QuantumMatter/Rumission/Hardware/rumission.footprints.3dmodels/pololu-1a-step-down-voltage-regulator-d24v10fx.step

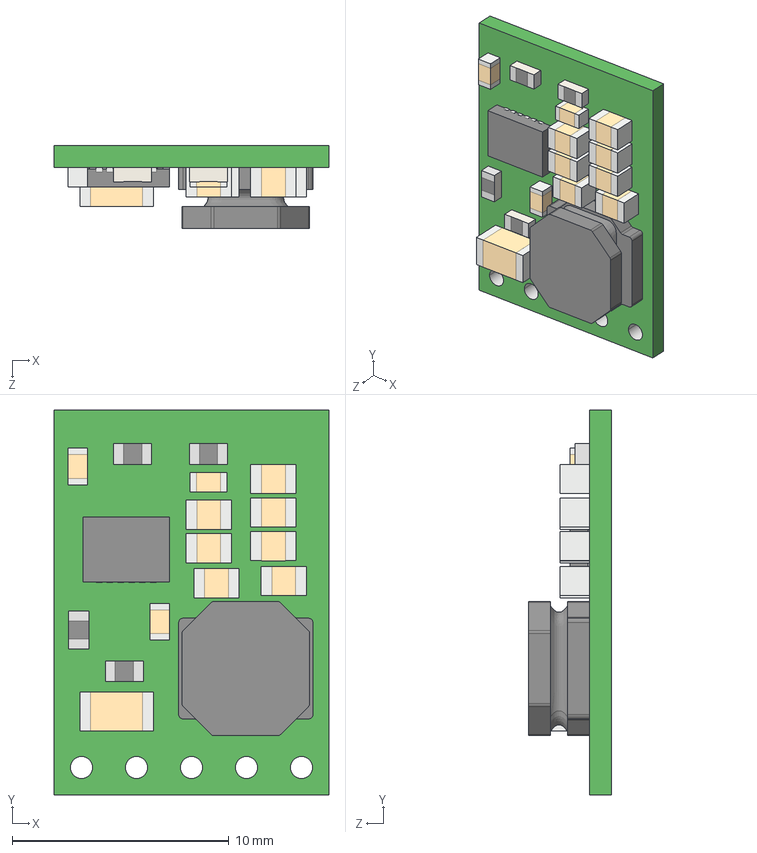
[picture p2: CAD file, 2023-12-21]
Hardware/rumission.footprints.3dmodels/pololu-1a-step-down-voltage-regulator-d24v10fx.step
12.7 x 17.8 x 3.82 mm
