QuantumMatter/Rumission/Hardware/rumission.footprints.3dmodels/SOT-26.stp

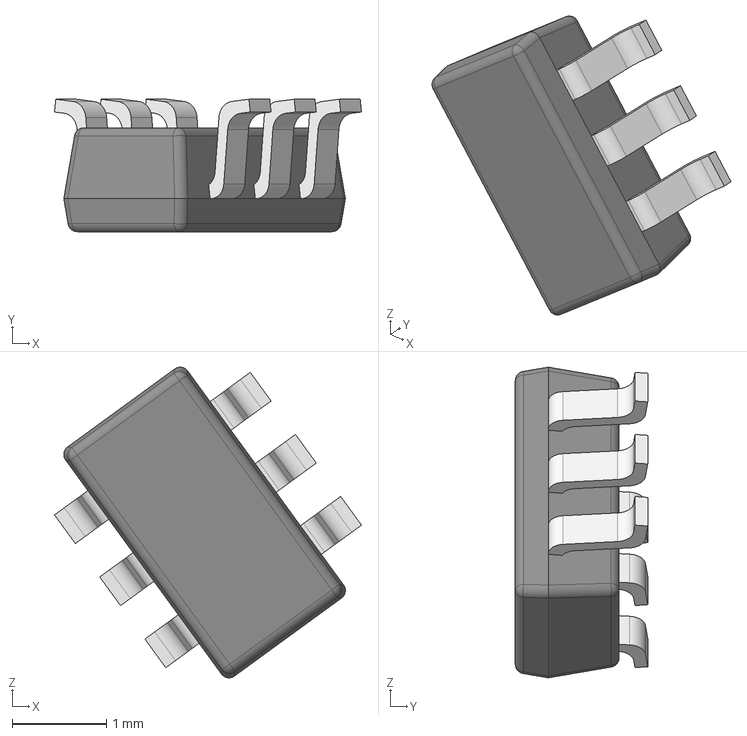
[picture p3: CAD file, 2023-12-21]
Hardware/rumission.footprints.3dmodels/SOT-26.stp
3.25 x 1.40 x 3.29 mm
LF
CP1
