QuantumMatter/Rumission/Hardware/rumission.footprints.3dmodels/Sensirion_Differential_Pressure_Sensors_SDP3x_STEP_file.step

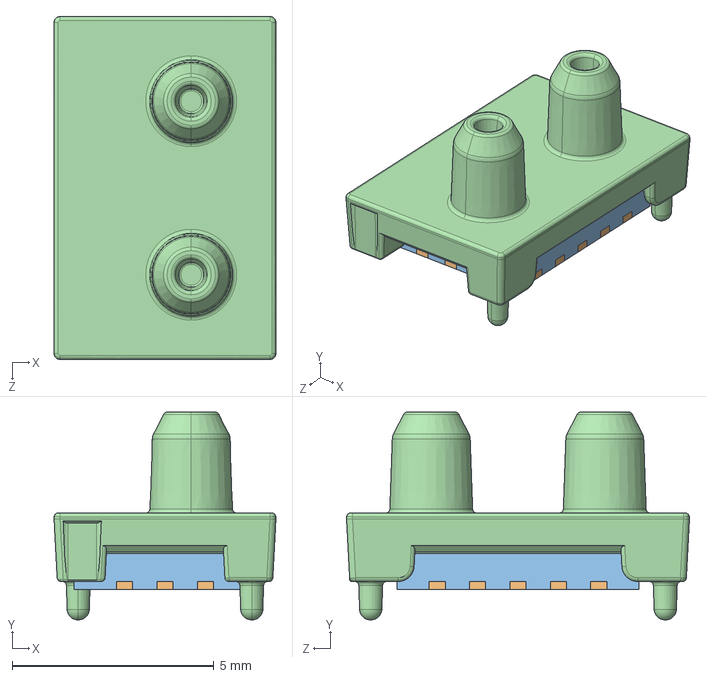
[picture p4: CAD file, 2023-12-21]
Hardware/rumission.footprints.3dmodels/Sensirion_Differential_Pressure_Sensors_SDP3x_STEP_file.step
5.50 x 5.15 x 8.50 mm
