QuantumMatter/Rumission/Hardware/rumission.footprints.3dmodels/CUI_PYBE30-Q24-S12.step

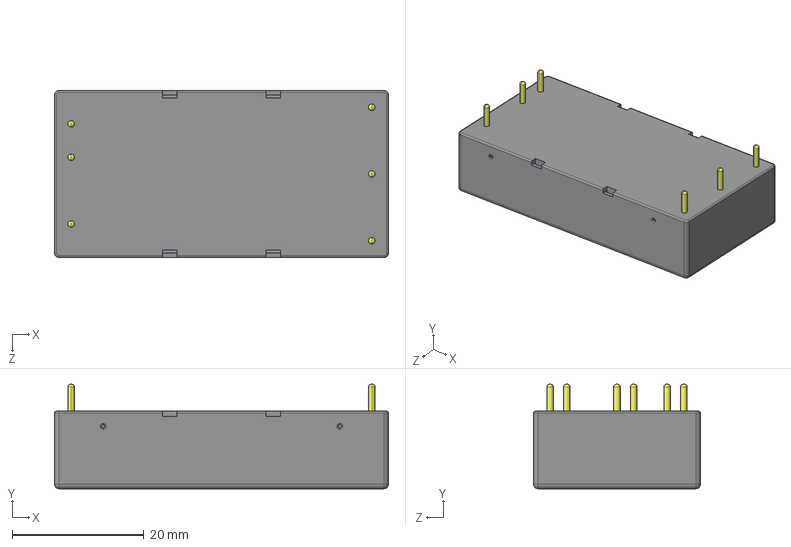
[picture p5: CAD file, 2023-12-21]
Hardware/rumission.footprints.3dmodels/CUI_PYBE30-Q24-S12.step
50.8 x 15.9 x 25.4 mm
