QuantumMatter/Rumission/Hardware/Daughter Boards/dboards-02/10_main_root.kicad_sch

## KiCad design Hardware/Daughter Boards/dboards-02/10_main_root.kicad_sch (2023-12-21)

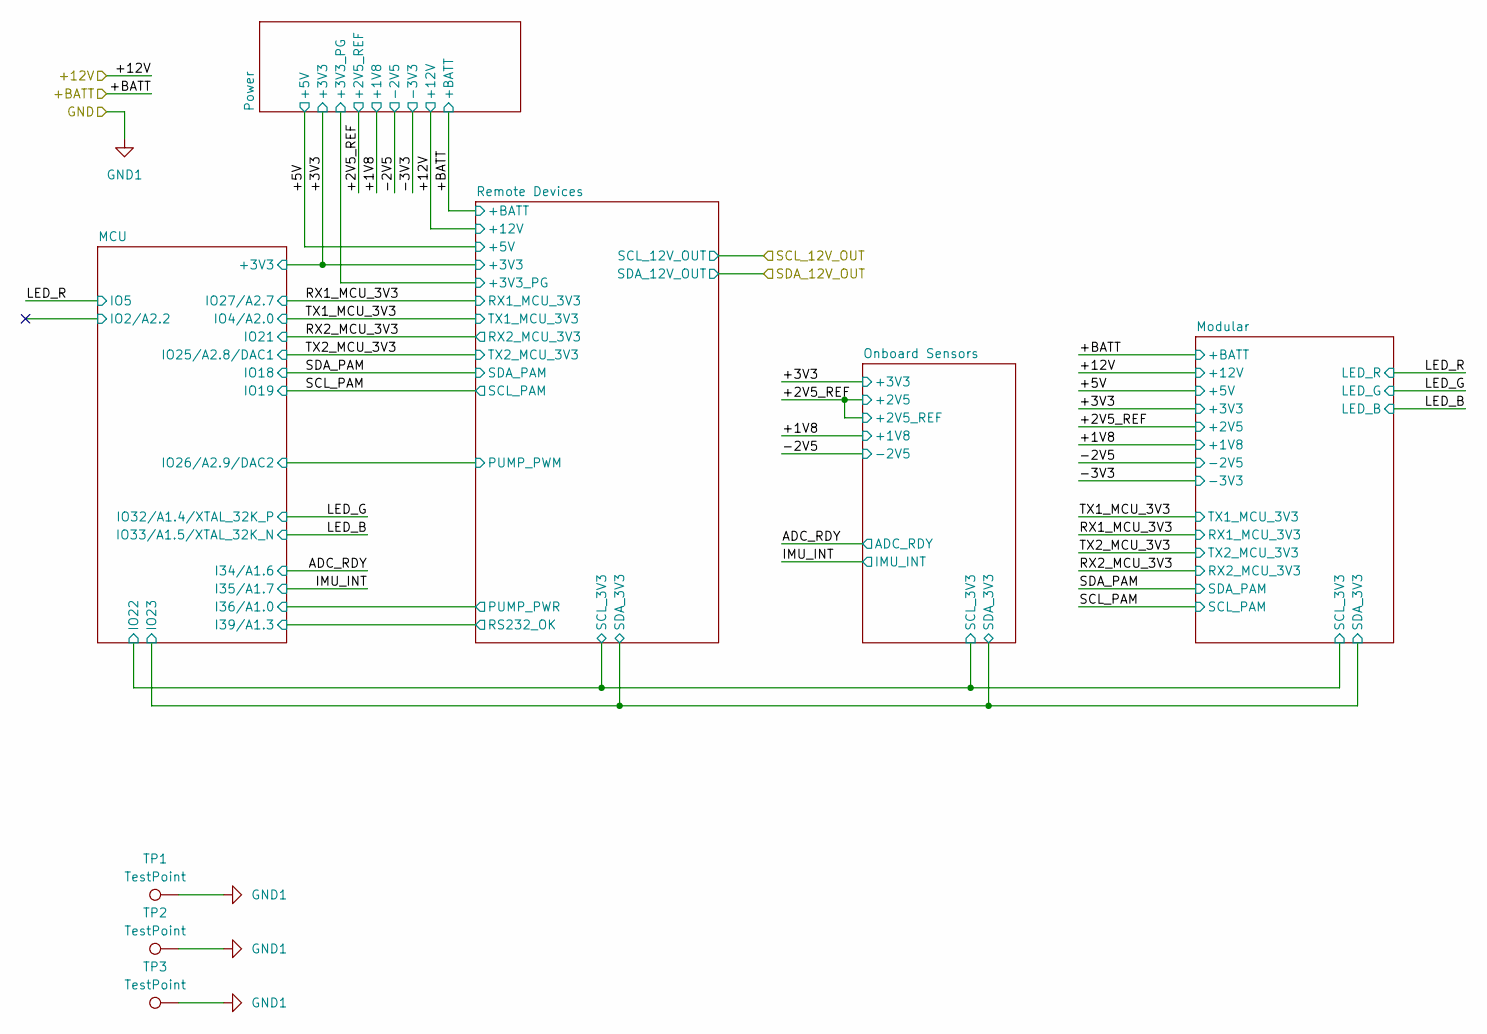
[picture p6: schematic 10_main_root.kicad_sch]

Parts:
TP1, TP2, TP3: TestPoint; TestPoint_Loop_D2.60mm_Drill1.6mm_Beaded; MPN 5011; DigiKey PN 36-5011-ND

Connections:
GND1: TP1.1, TP2.1, TP3.1
