QuantumMatter/Rumission/Hardware/Daughter Boards/dboards-02/11_main_mcu.kicad_sch

## KiCad design Hardware/Daughter Boards/dboards-02/11_main_mcu.kicad_sch (2023-12-21)

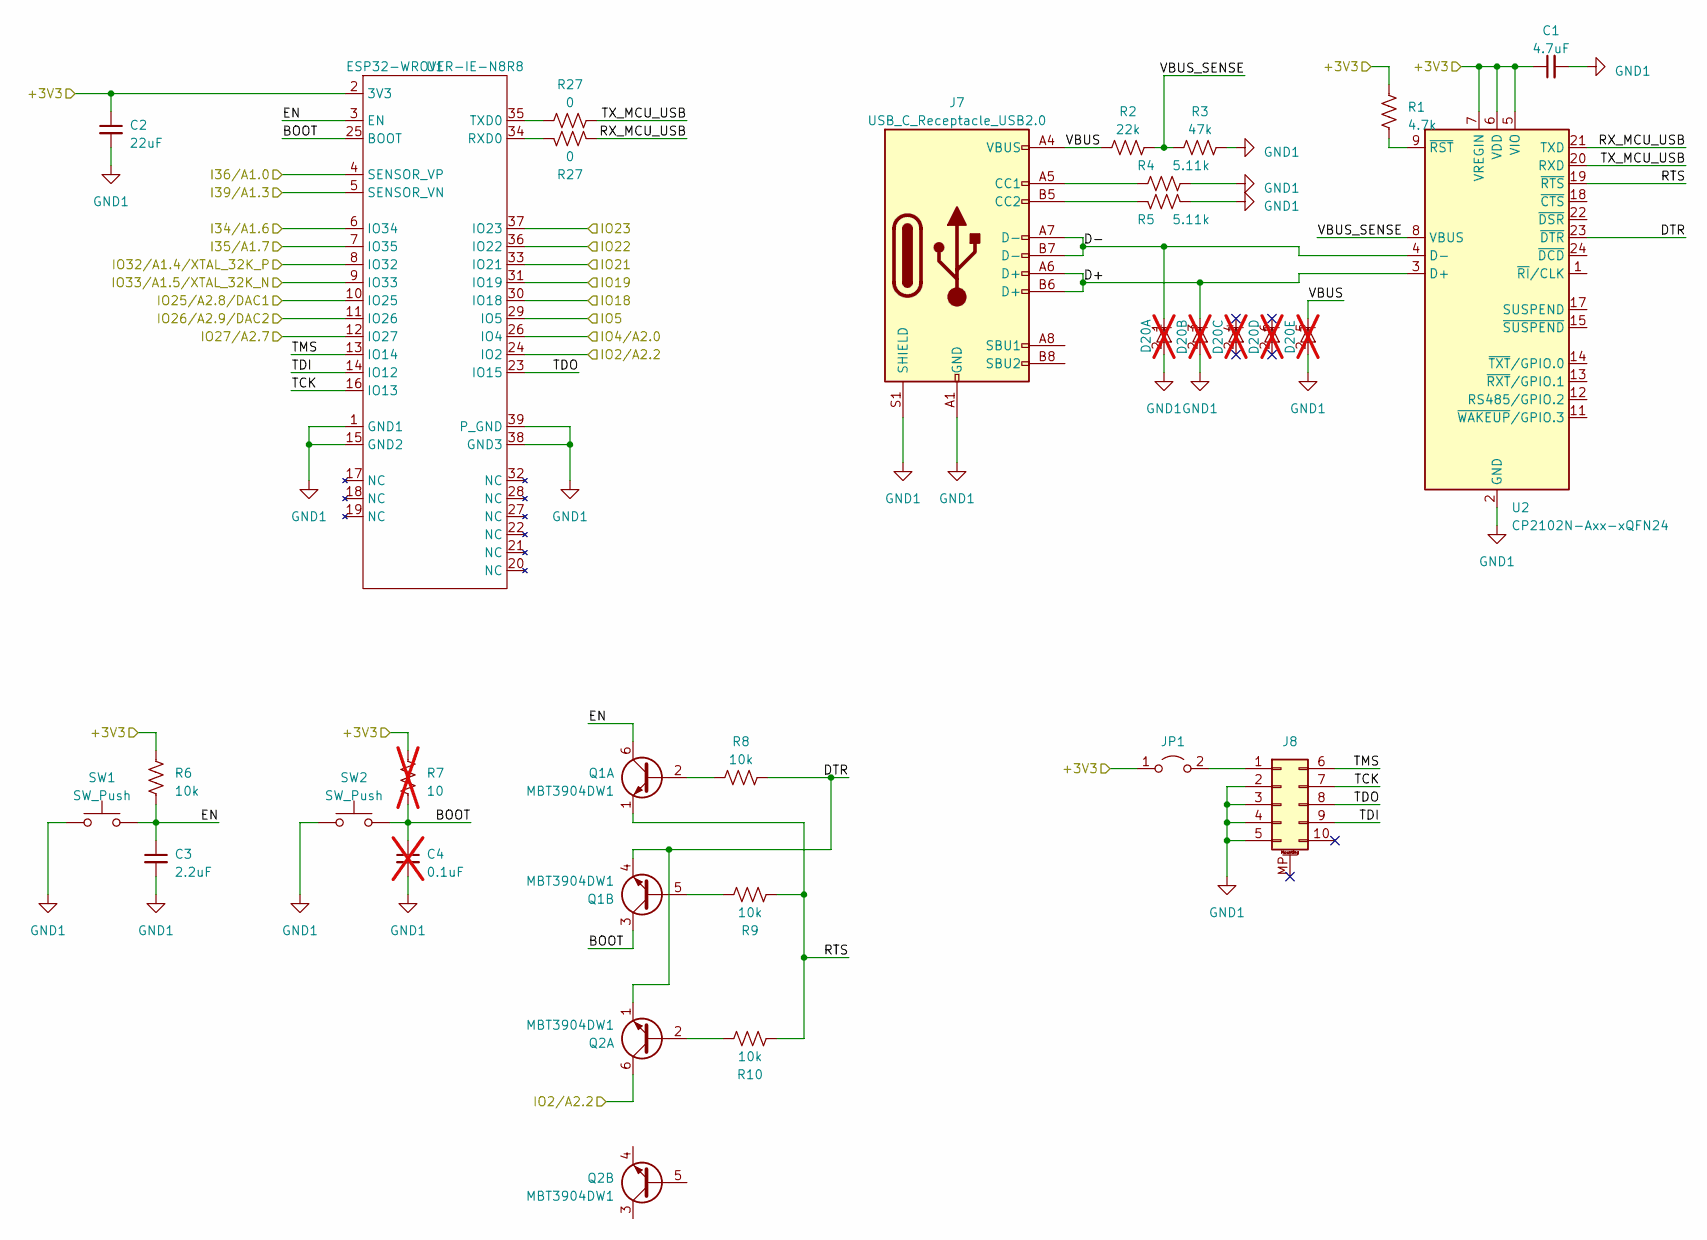
[picture p7: schematic 11_main_mcu.kicad_sch]

Parts:
C1: 4.7uF; C_0805_2012Metric_Pad1.18x1.45mm_HandSolder; MPN CL21A475KAQNNNE; DigiKey PN 1276-1244-1-ND
C2: 22uF; C_0805_2012Metric_Pad1.18x1.45mm_HandSolder; MPN CL21A226MOCLRNC; DigiKey PN 1276-6780-1-ND
C3: 2.2uF; CP_Radial_D5.0mm_P2.00mm; MPN ESK225M100AC3AA; DigiKey PN 399-18273-ND
C4: 0.1uF; C_Disc_D5.0mm_W2.5mm_P5.00mm; MPN FA28X8R1E104KNU00; DigiKey PN 445-181217-ND; not fitted
D20: D5V0F4U6SO; SOT26; MPN D5V0F4U6SO-7; DigiKey PN D5V0F4U6SO-7DICT-ND; not fitted
J7: USB_C_Receptacle_USB2.0; USB_C_Receptacle_GCT_USB4115-03-C; MPN USB4115-03-C; DigiKey PN 2073-USB4115-03-CCT-ND
J8: Conn_02x05_Top_Bottom_MountingPin; PinSocket_2x05_P2.54mm_Vertical; MPN 302-S101; DigiKey PN ED1543-ND
JP1: Jumper_2_Open; PinHeader_1x02_P2.54mm_Vertical; MPN 77311-118-02LF; DigiKey PN 609-4434-ND
Q1, Q2: MBT3904DW1; SOT-363_SC-70-6; MPN MBT3904DW1T3G; DigiKey PN MBT3904DW1T3GOSCT-ND
R1: 4.7k; R_0805_2012Metric_Pad1.20x1.40mm_HandSolder; MPN MFR-25FTF52-4K7; DigiKey PN 13-MFR-25FTF52-4K7CT-ND
R2: 22k; R_Axial_DIN0207_L6.3mm_D2.5mm_P10.16mm_Horizontal; MPN MFR-25FRF52-22K; DigiKey PN 13-MFR-25FRF52-22KCT-ND
R3: 47k; R_Axial_DIN0207_L6.3mm_D2.5mm_P10.16mm_Horizontal; MPN MFR-25FRF52-47K; DigiKey PN 13-MFR-25FRF52-47KCT-ND
R4, R5: 5.11k; R_Axial_DIN0207_L6.3mm_D2.5mm_P10.16mm_Horizontal; MPN MFR-25FRF52-5K11; DigiKey PN 13-MFR-25FRF52-5K11CT-ND
R6: 10k; R_Axial_DIN0207_L6.3mm_D2.5mm_P10.16mm_Horizontal; MPN MFR-25FRF52-10K; DigiKey PN 13-MFR-25FRF52-10KCT-ND
R7: 10; R_Axial_DIN0207_L6.3mm_D2.5mm_P10.16mm_Horizontal; MPN MFR-25FTF52-10R; DigiKey PN 13-MFR-25FTF52-10RCT-ND; not fitted
R8, R9, R10: 10k; R_0805_2012Metric_Pad1.20x1.40mm_HandSolder; MPN RC0805FR-0710KL; DigiKey PN 311-10.0KCRCT-ND
R27: 0; R_0805_2012Metric_Pad1.20x1.40mm_HandSolder; MPN RC0805JR-070RL; DigiKey PN 311-0.0ARCT-ND
SW1: SW_Push; SW_SPST_PTS645; MPN PTS645SH43SMTR92 LFS; DigiKey PN CKN11907CT-ND
SW2: SW_Push; SW_SPST_PTS645; MPN PTS645SM43SMTR92 LFS; DigiKey PN CKN9112CT-ND
U1: ESP32-WROVER-IE-N8R8; ESP32-WROVER; MPN ESP32-WROVER-IE-N8R8; DigiKey PN 1965-ESP32-WROVER-IE-N8R8CT-ND
U2: CP2102N-Axx-xQFN24; QFN-24-1EP_4x4mm_P0.5mm_EP2.6x2.6mm; MPN CP2102N-A02-GQFN24; DigiKey PN 336-5887-ND

Connections:
+3V3: C1.1, C2.1, JP1.1 (A), R1.1, R6.1, R7.1, U1.2 (3V3), U2.5 (VIO), U2.6 (VDD), U2.7 (VREGIN)
BOOT: C4.1, Q1.3 (C2), R7.2, SW2.2, U1.25 (BOOT)
D+: D20.3 (K2), J7.A6 (D+), J7.B6 (D+), U2.3 (D+)
D-: D20.1 (K1), J7.A7 (D-), J7.B7 (D-), U2.4 (D-)
DTR: Q1.4 (E2), Q2.1 (E1), R8.2, U2.23 (~DTR)
EN: C3.1, Q1.6 (C1), R6.2, SW1.2, U1.3 (EN)
GND1: C1.2, C2.2, C3.2, C4.2, D20.2 (A), J7.A1 (GND), J7.A12 (GND), J7.B1 (GND), J7.B12 (GND), J7.S1 (SHIELD), J8.2, J8.3, J8.4, J8.5, R3.1, R4.1, R5.1, SW1.1, SW2.1, U1.1 (GND1), U1.15 (GND2), U1.38 (GND3), U1.39 (P_GND), U2.2 (GND), U2.25 (GND)
I34/A1.6: U1.6 (IO34)
I35/A1.7: U1.7 (IO35)
I36/A1.0: U1.4 (SENSOR_VP)
I39/A1.3: U1.5 (SENSOR_VN)
IO2/A2.2: Q2.6 (C1), U1.24 (IO2)
IO4/A2.0: U1.26 (IO4)
IO5: U1.29 (IO5)
IO18: U1.30 (IO18)
IO19: U1.31 (IO19)
IO21: U1.33 (IO21)
IO22: U1.36 (IO22)
IO23: U1.37 (IO23)
IO25/A2.8/DAC1: U1.10 (IO25)
IO26/A2.9/DAC2: U1.11 (IO26)
IO27/A2.7: U1.12 (IO27)
IO32/A1.4/XTAL_32K_P: U1.8 (IO32)
IO33/A1.5/XTAL_32K_N: U1.9 (IO33)
unnamed: J7.A5 (CC1), R4.2
unnamed: J7.B5 (CC2), R5.2
unnamed: J8.1, JP1.2 (B)
unnamed: Q1.2 (B1), R8.1
unnamed: Q1.5 (B2), R9.1
unnamed: Q2.2 (B1), R10.1
unnamed: R1.2, U2.9 (~RST)
unnamed: R27.1, U1.34 (RXD0), U1.35 (TXD0)
RTS: Q1.1 (E1), R9.2, R10.2, U2.19 (~RTS)
RX_MCU_USB: R27.2, U2.21 (TXD)
TCK: J8.7, U1.16 (IO13)
TDI: J8.9, U1.14 (IO12)
TDO: J8.8, U1.23 (IO15)
TMS: J8.6, U1.13 (IO14)
TX_MCU_USB: R27.2, U2.20 (RXD)
VBUS: D20.5 (K_Vcc), J7.A4 (VBUS), J7.A9 (VBUS), J7.B4 (VBUS), J7.B9 (VBUS), R2.1
VBUS_SENSE: R2.2, R3.2, U2.8 (VBUS)
