QuantumMatter/Rumission/Hardware/Daughter Boards/dboards-02/12_main_power.kicad_sch

## KiCad design Hardware/Daughter Boards/dboards-02/12_main_power.kicad_sch (2023-12-21)

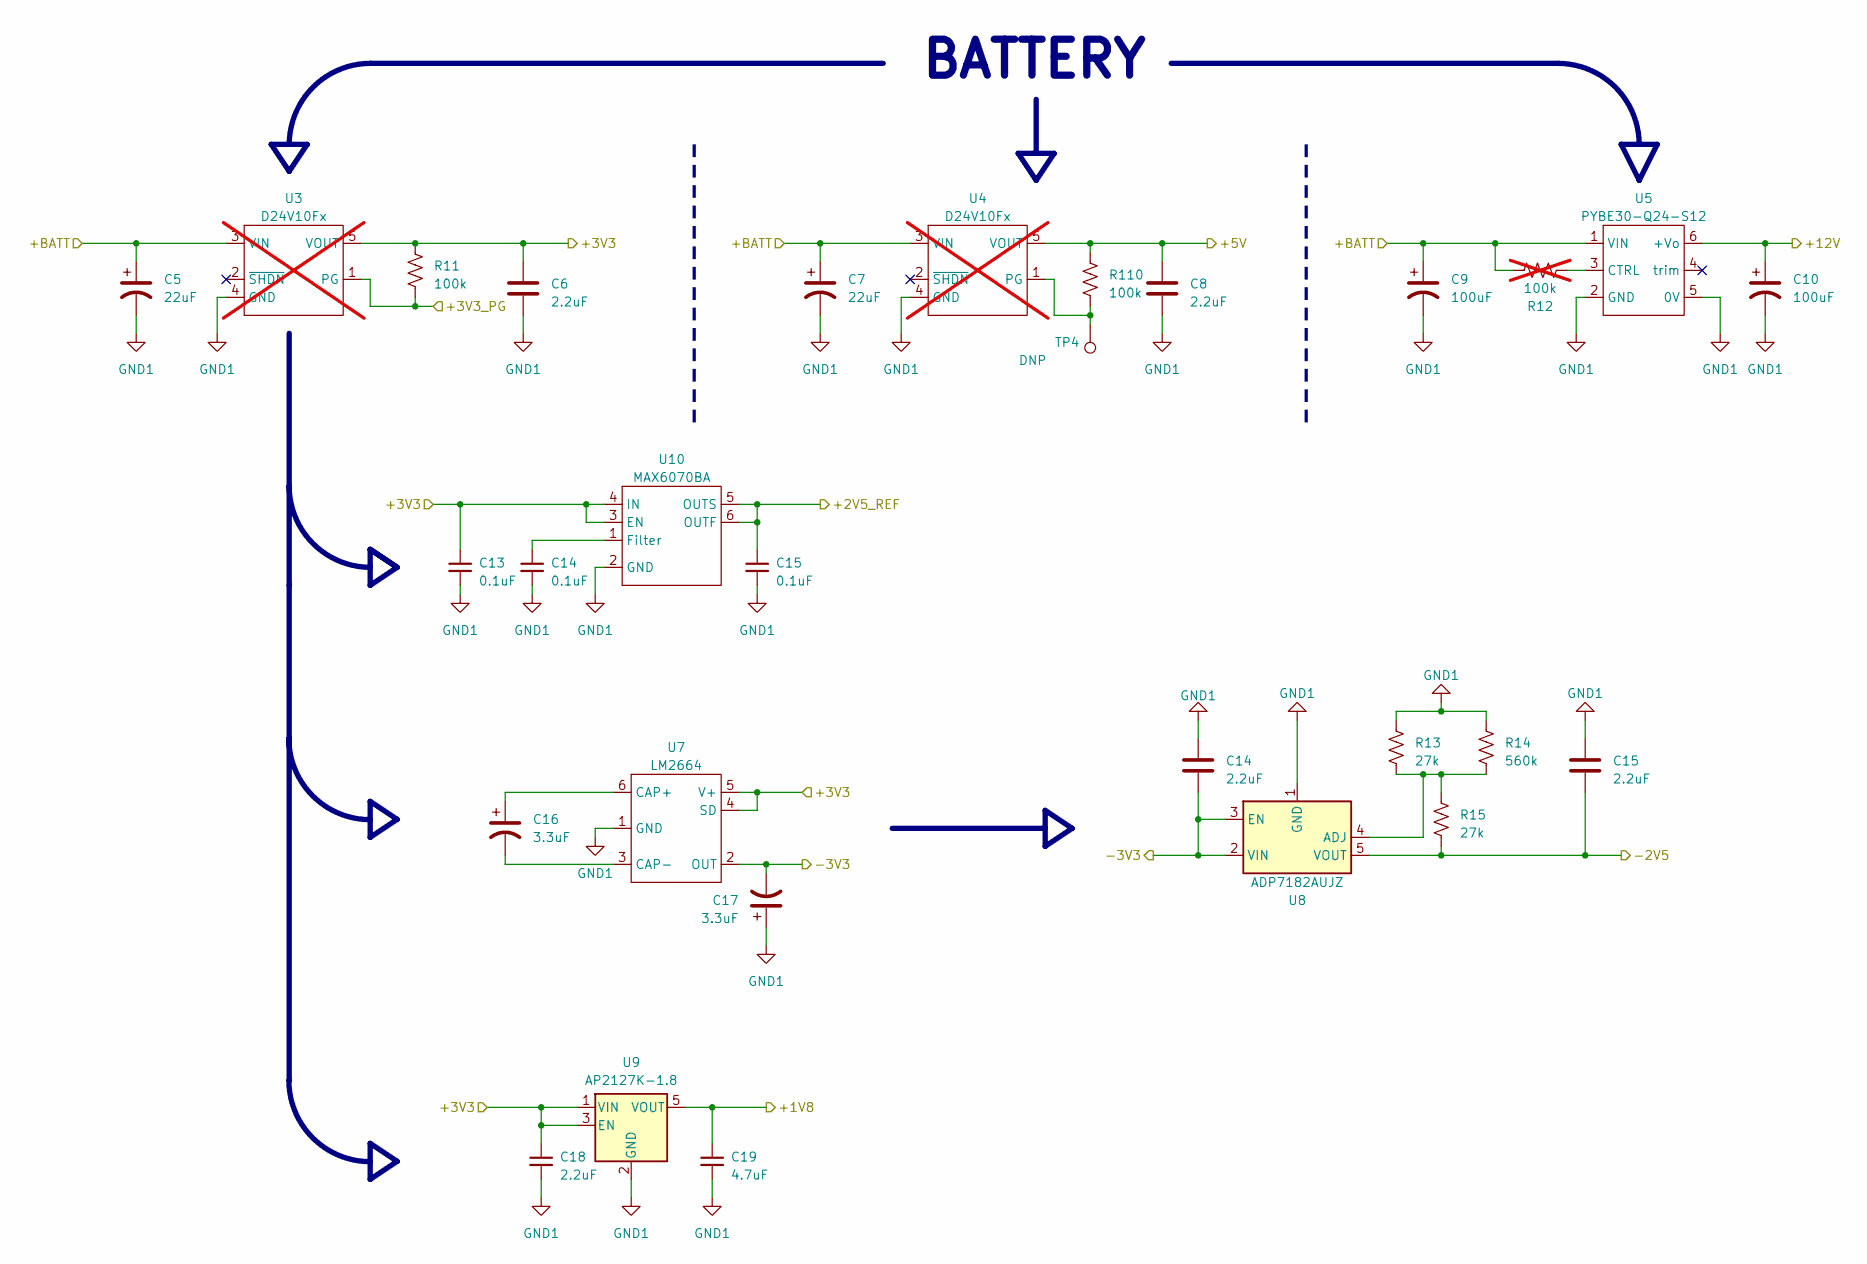
[picture p8: schematic 12_main_power.kicad_sch]

Parts:
C5, C7: 22uF; CP_Radial_D6.3mm_P2.50mm; MPN EEA-GA1H2R2H; DigiKey PN P15835CT-ND
C6, C8, C14, C18: 2.2uF; C_0805_2012Metric_Pad1.18x1.45mm_HandSolder; MPN CL21B225KPFNNNE; DigiKey PN 1276-1188-1-ND
C9, C10: 100uF; CP_Radial_D6.3mm_P2.50mm; MPN ESK107M025AE3EA; DigiKey PN 399-6650-1-ND
C13, C15: 0.1uF; C_0805_2012Metric_Pad1.18x1.45mm_HandSolder; MPN CL21B104KACNNNC; DigiKey PN 1276-1099-1-ND
C16, C17: 3.3uF; C_0805_2012Metric_Pad1.18x1.45mm_HandSolder; MPN CL21A335KPFNNNG; DigiKey PN 1276-6461-1-ND
C19: 4.7uF; C_0805_2012Metric_Pad1.18x1.45mm_HandSolder; MPN CL21A475KAQNNNE; DigiKey PN 1276-1244-1-ND
R11, R110: 100k; R_0805_2012Metric_Pad1.20x1.40mm_HandSolder; MPN RC0805FR-07100KL; DigiKey PN 311-100KCRCT-ND
R12: 100k; R_Axial_DIN0207_L6.3mm_D2.5mm_P10.16mm_Horizontal; MPN MFR-25FRF52-100K; DigiKey PN 13-MFR-25FRF52-100KCT-ND; not fitted
R13, R15: 27k; R_Axial_DIN0207_L6.3mm_D2.5mm_P10.16mm_Horizontal; MPN MFR-25FRF52-27K; DigiKey PN 13-MFR-25FRF52-27KCT-ND
R14: 560k; R_Axial_DIN0207_L6.3mm_D2.5mm_P10.16mm_Horizontal; MPN MFR-25FRF52-560K; DigiKey PN 13-MFR-25FRF52-560KCT-ND
TP4: DNP; TestPoint_Pad_2.0x2.0mm
U3: D24V10Fx; MPN D24V10F3; not fitted
U4: D24V10Fx; MPN D24V10F5; not fitted
U5: PYBE30-Q24-S12; DIP-6-DCDC; MPN PYBE30-Q24-S12; DigiKey PN 102-6018-ND
U7: LM2664; SOT-23-6; MPN LM2664M6/NOPB; DigiKey PN LM2664M6/NOPBCT-ND
U8: ADP7182AUJZ; TSOT-23-5; MPN ADP7182AUJZ-2.5-R7; DigiKey PN 505-ADP7182AUJZ-2.5-R7CT-ND
U9: AP2127K-1.8; SOT-23-5; MPN AP2127K-1.8TRG1; DigiKey PN AP2127K-1.8TRG1DICT-ND
U10: MAX6070BA; SOT-23-6; MPN MAX6070BAUT25+T; DigiKey PN MAX6070BAUT25+TCT-ND

Connections:
+1V8: C19.1, U9.5 (VOUT)
+2V5_REF: C15.1, U10.5 (OUTS), U10.6 (OUTF)
+3V3: C6.1, C13.1, C18.1, R11.1, U3.5 (VOUT), U7.4 (SD), U7.5 (V+), U9.1 (VIN), U9.3 (EN), U10.3 (EN), U10.4 (IN)
+3V3_PG: R11.2, U3.1 (PG)
+5V: C8.1, R110.1, U4.5 (VOUT)
+12V: C10.1, U5.6 (+Vo)
+BATT: C5.1, C7.1, C9.1, R12.2, U3.3 (VIN), U4.3 (VIN), U5.1 (VIN)
-2V5: C15.2, R15.2, U8.5 (VOUT)
-3V3: C14.2, C17.2, U7.2 (OUT), U8.2 (VIN), U8.3 (EN)
GND1: C5.2, C6.2, C7.2, C8.2, C9.2, C10.2, C13.2, C14.1, C14.2, C15.1, C15.2, C17.1, C18.2, C19.2, R13.1, R14.1, U3.4 (GND), U4.4 (GND), U5.2 (GND), U5.5 (0V), U7.1 (GND), U8.1 (GND), U9.2 (GND), U10.2 (GND)
unnamed: C14.1, U10.1 (Filter)
unnamed: C16.1, U7.6 (CAP+)
unnamed: C16.2, U7.3 (CAP-)
unnamed: R12.1, U5.3 (CTRL)
unnamed: R13.2, R14.2, R15.1, U8.4 (ADJ)
unnamed: R110.2, TP4.1, U4.1 (PG)

Notes on the sheet:
BATTERY
