QuantumMatter/Rumission/Hardware/Daughter Boards/dboards-02/13_main_onboard-sensors.kicad_sch

## KiCad design Hardware/Daughter Boards/dboards-02/13_main_onboard-sensors.kicad_sch (2023-12-21)

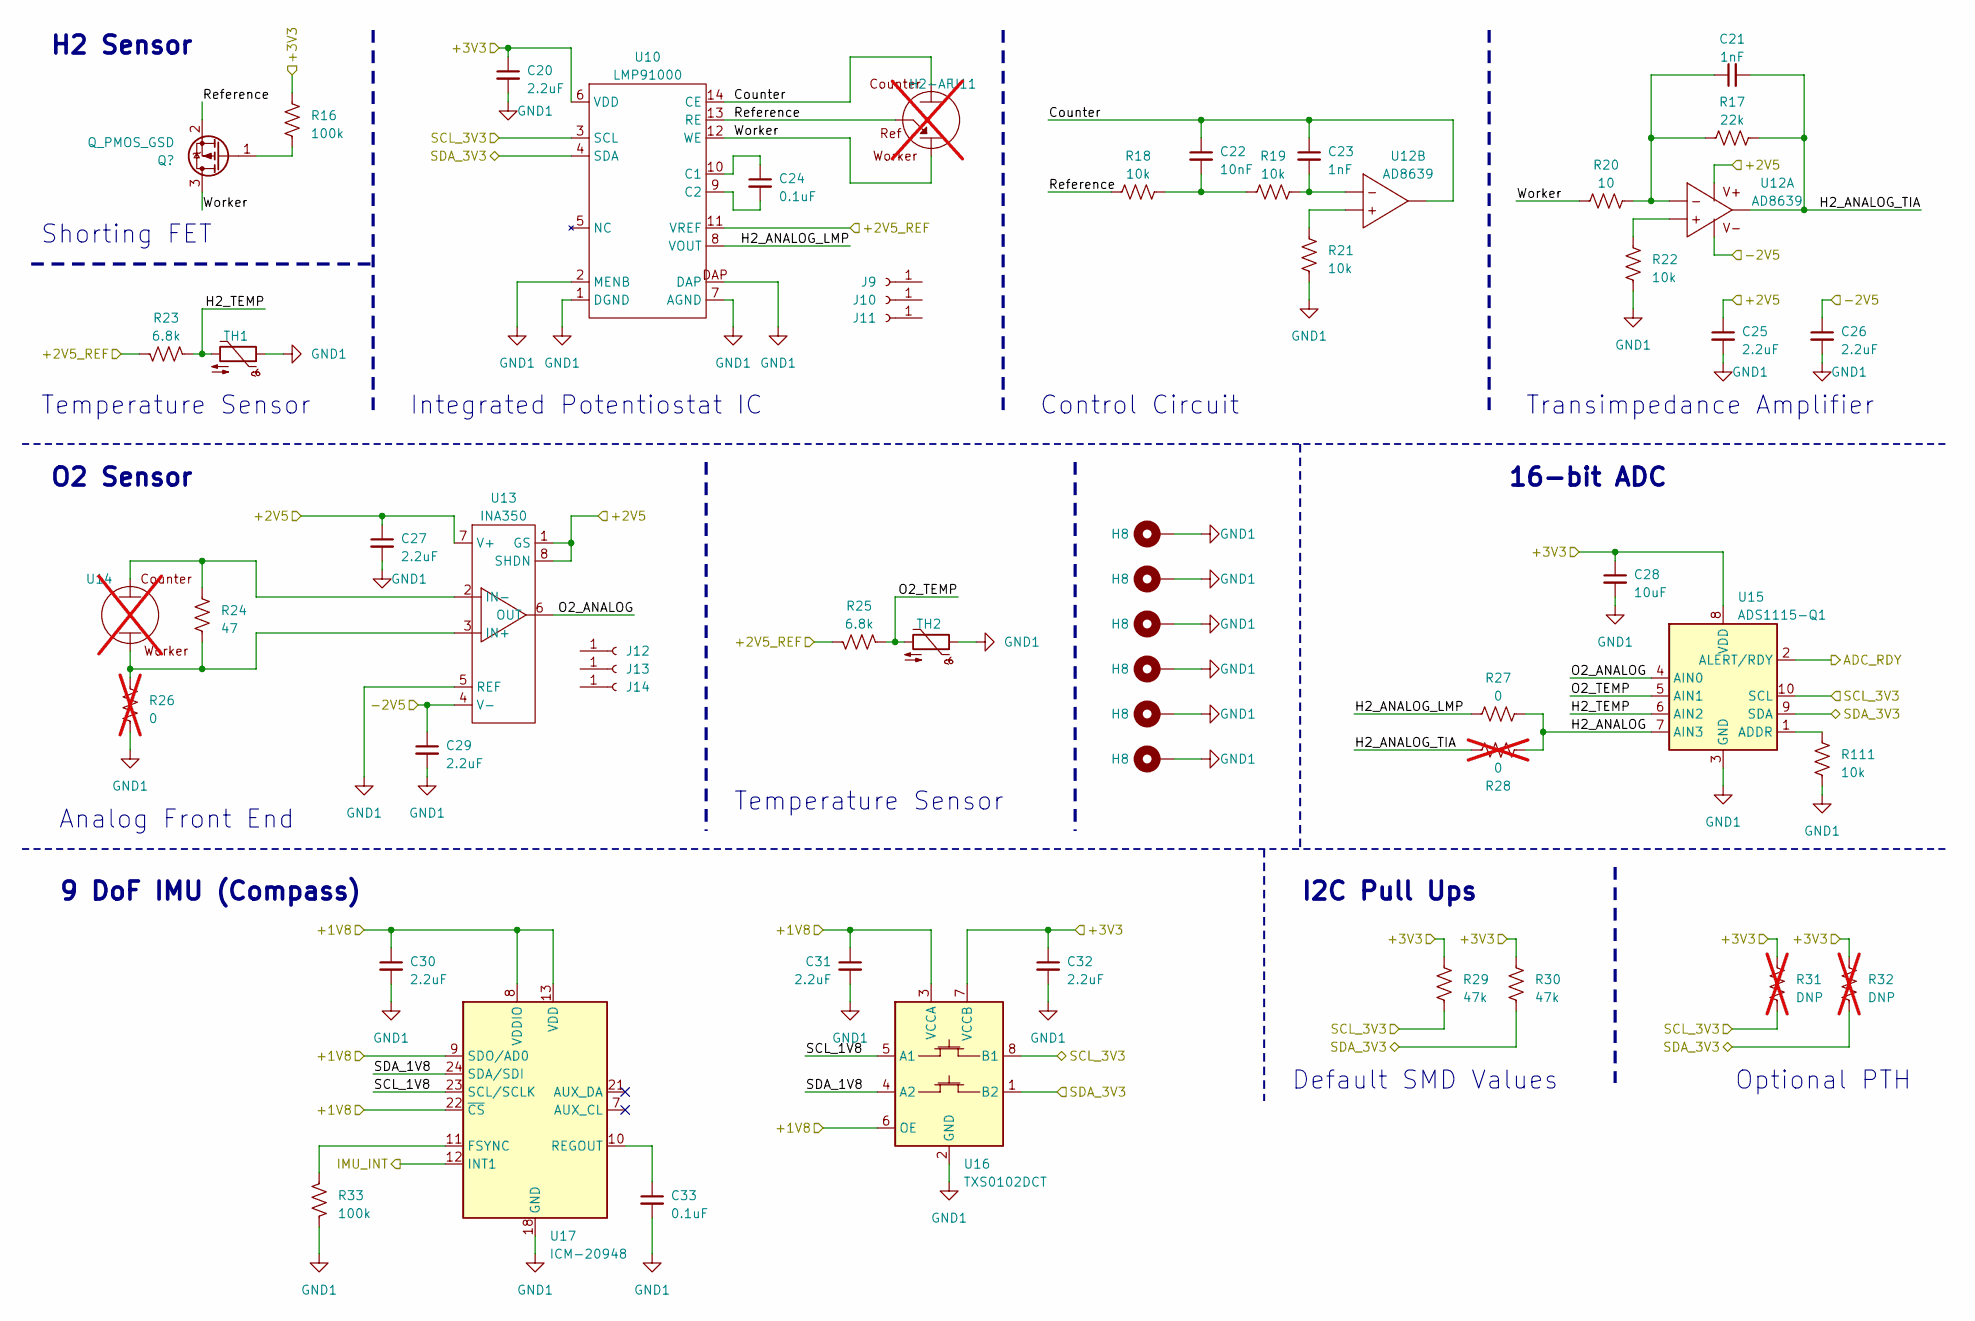
[picture p9: schematic 13_main_onboard-sensors.kicad_sch]

Parts:
C20, C25, C26, C27, C29, C30, C31, C32: 2.2uF; C_0805_2012Metric_Pad1.18x1.45mm_HandSolder; MPN CL21B225KPFNNNE; DigiKey PN 1276-1188-1-ND
C21, C23: 1nF; C_0805_2012Metric_Pad1.18x1.45mm_HandSolder; MPN AC0805KRX7R8BB102; DigiKey PN 311-3167-1-ND
C22: 10nF; C_0805_2012Metric_Pad1.18x1.45mm_HandSolder; MPN AC0805KRX7R8BB103; DigiKey PN 311-3168-1-ND
C24, C33: 0.1uF; C_0805_2012Metric_Pad1.18x1.45mm_HandSolder; MPN CL21B104KACNNNC; DigiKey PN 1276-1099-1-ND
C28: 10uF; C_0805_2012Metric_Pad1.18x1.45mm_HandSolder; MPN CL21A106KOQNNNE; DigiKey PN 1276-1096-1-ND
H8: MountingHole_Pad; MountingHole_3.2mm_M3_DIN965_Pad
J9, J10, J11, J12, J13, J14: 0364 RECEPTACLE WITH NO TAIL; MPN 0364-0-15-15-13-27-10-0; DigiKey PN ED90089-ND
Q1: Q_PMOS_GSD; SOT-523; MPN DMP21D0UT-7; DigiKey PN DMP21D0UT-7DITR-ND
R16: 100k; R_0805_2012Metric_Pad1.20x1.40mm_HandSolder; MPN RC0805FR-07100KL; DigiKey PN 311-100KCRCT-ND
R17: 22k; R_Axial_DIN0207_L6.3mm_D2.5mm_P10.16mm_Horizontal; MPN MFR-25FRF52-22K; DigiKey PN 13-MFR-25FRF52-22KCT-ND
R18, R19, R21, R22, R111: 10k; R_0805_2012Metric_Pad1.20x1.40mm_HandSolder; MPN RC0805FR-0710KL; DigiKey PN 311-10.0KCRCT-ND
R20: 10; R_Axial_DIN0207_L6.3mm_D2.5mm_P10.16mm_Horizontal; MPN MFR-25FTF52-10R; DigiKey PN 13-MFR-25FTF52-10RCT-ND
R23, R25: 6.8k; R_Axial_DIN0207_L6.3mm_D2.5mm_P10.16mm_Horizontal; MPN MFR-25FRF52-6K8; DigiKey PN 13-MFR-25FRF52-6K8CT-ND
R24: 47; R_Axial_DIN0207_L6.3mm_D2.5mm_P10.16mm_Horizontal; MPN MFR-25FTE52-47R; DigiKey PN 13-MFR-25FTE52-47RCT-ND
R26: 0; R_Axial_DIN0207_L6.3mm_D2.5mm_P10.16mm_Horizontal; MPN MFR-25-T-52-0R; DigiKey PN 13-MFR-25-T-52-0RCT-ND; not fitted
R27: 0; R_0805_2012Metric_Pad1.20x1.40mm_HandSolder; MPN RC0805JR-070RL; DigiKey PN 311-0.0ARCT-ND
R28: 0; R_0805_2012Metric_Pad1.20x1.40mm_HandSolder; MPN RC0805JR-070RL; DigiKey PN 311-0.0ARCT-ND; not fitted
R29, R30: 47k; R_0805_2012Metric_Pad1.20x1.40mm_HandSolder; MPN RC0805FR-0747KL; DigiKey PN 311-47.0KCRCT-ND
R31, R32: DNP; R_Axial_DIN0207_L6.3mm_D2.5mm_P10.16mm_Horizontal; not fitted
R33: 100k; R_Axial_DIN0207_L6.3mm_D2.5mm_P10.16mm_Horizontal; MPN MFR-25FRF52-100K; DigiKey PN 13-MFR-25FRF52-100KCT-ND
TH1, TH2: TX08F103F3435ER; R_0805_2012Metric_Pad1.20x1.40mm_HandSolder; MPN TX08F103F3435ER; DigiKey PN 273-TX08F103F3435ERCT-ND
U10: LMP91000; WSON-14-1EP_4.0x4.0mm_P0.5mm_EP2.6x2.6mm; MPN LMP91000SD/NOPB; DigiKey PN 296-44382-1-ND
U11: H2-AF; not fitted
U12: AD8639; SOIC-8_3.9x4.9mm_P1.27mm; MPN AD8639ARZ; DigiKey PN 505-AD8639ARZ-ND
U13: INA350; SOT-23-8; MPN INA350CDSIDDFR; DigiKey PN 296-INA350CDSIDDFRCT-ND
U14: O2-A1; H2-AF; not fitted
U15: ADS1115-Q1; VSSOP-10_3x3mm_P0.5mm; MPN ADS1115BQDGSRQ1; DigiKey PN 296-45221-1-ND
U16: TXS0102DCT; SSOP-8_2.95x2.8mm_P0.65mm; MPN TXS0102DCTR; DigiKey PN 296-21978-1-ND
U17: ICM-20948; InvenSense_QFN-24_3x3mm_P0.4mm; MPN ICM-20948; DigiKey PN 1428-1123-1-ND

Connections:
+1V8: C30.1, C31.1, U16.3 (VCCA), U16.6 (OE), U17.8 (VDDIO), U17.9 (SDO/AD0), U17.13 (VDD), U17.22 (~CS)
+2V5: C25.1, C27.1, U12.4 (V-), U13.1 (GS), U13.7 (V+), U13.8 (SHDN)
+2V5_REF: R23.1, R25.1, U10.11 (VREF)
+3V3: C20.1, C28.1, C32.1, R16.1, R29.1, R30.1, R31.1, R32.1, U10.6 (VDD), U15.8 (VDD), U16.7 (VCCB)
-2V5: C26.1, C29.1, U12.8 (V+), U13.4 (V-)
ADC_RDY: U15.2 (ALERT/RDY)
Counter: C22.1, C23.1, U10.14 (CE), U11.3 (Counter), U12.7 (OUT)
GND1: C20.2, C25.2, C26.2, C27.2, C28.2, C29.2, C30.2, C31.2, C32.2, C33.2, H8.1, R21.1, R22.1, R26.2, R33.2, R111.1, TH1.1, TH2.1, U10.1 (DGND), U10.2 (MENB), U10.7 (AGND), U10.DAP, U13.5 (REF), U15.3 (GND), U16.2 (GND), U17.18 (GND), U17.20 (GND)
H2_ANALOG: R27.2, R28.2, U15.7 (AIN3)
H2_ANALOG_LMP: R27.1, U10.8 (VOUT)
H2_ANALOG_TIA: C21.2, R17.2, R28.1, U12.1 (OUT)
H2_TEMP: R23.2, TH1.2, U15.6 (AIN2)
IMU_INT: U17.12 (INT1)
unnamed: C21.1, R17.1, R20.2, U12.2 (IN-)
unnamed: C22.2, R18.2, R19.1
unnamed: C23.2, R19.2, U12.6 (IN-)
unnamed: C24.1, U10.10 (C1)
unnamed: C24.2, U10.9 (C2)
unnamed: C33.1, U17.10 (REGOUT)
unnamed: Q1.1 (G), R16.2
unnamed: R21.2, U12.5 (IN+)
unnamed: R22.2, U12.3 (IN+)
unnamed: R24.1, U13.2 (IN-), U14.3 (Counter)
unnamed: R24.2, R26.1, U13.3 (IN+), U14.2 (Worker)
unnamed: R33.1, U17.11 (FSYNC)
unnamed: R111.2, U15.1 (ADDR)
O2_ANALOG: U13.6 (OUT), U15.4 (AIN0)
O2_TEMP: R25.2, TH2.2, U15.5 (AIN1)
Reference: Q1.2 (S), R18.1, U10.13 (RE), U11.1 (Reference)
SCL_1V8: U16.5 (A1), U17.23 (SCL/SCLK)
SCL_3V3: R29.2, R31.2, U10.3 (SCL), U15.10 (SCL), U16.8 (B1)
SDA_1V8: U16.4 (A2), U17.24 (SDA/SDI)
SDA_3V3: R30.2, R32.2, U10.4 (SDA), U15.9 (SDA), U16.1 (B2)
Worker: Q1.3 (D), R20.1, U10.12 (WE), U11.2 (Worker)

Notes on the sheet:
H2 Sensor
Integrated Potentiostat IC
Shorting FET
9 DoF IMU (Compass)
Transimpedance Amplifier
Temperature Sensor
O2 Sensor
Optional PTH
Control Circuit
I2C Pull Ups
Default SMD Values
Analog Front End
16-bit ADC
