QuantumMatter/Rumission/Hardware/Daughter Boards/dboards-02/14_main_remote-devices.kicad_sch

## KiCad design Hardware/Daughter Boards/dboards-02/14_main_remote-devices.kicad_sch (2023-12-21)

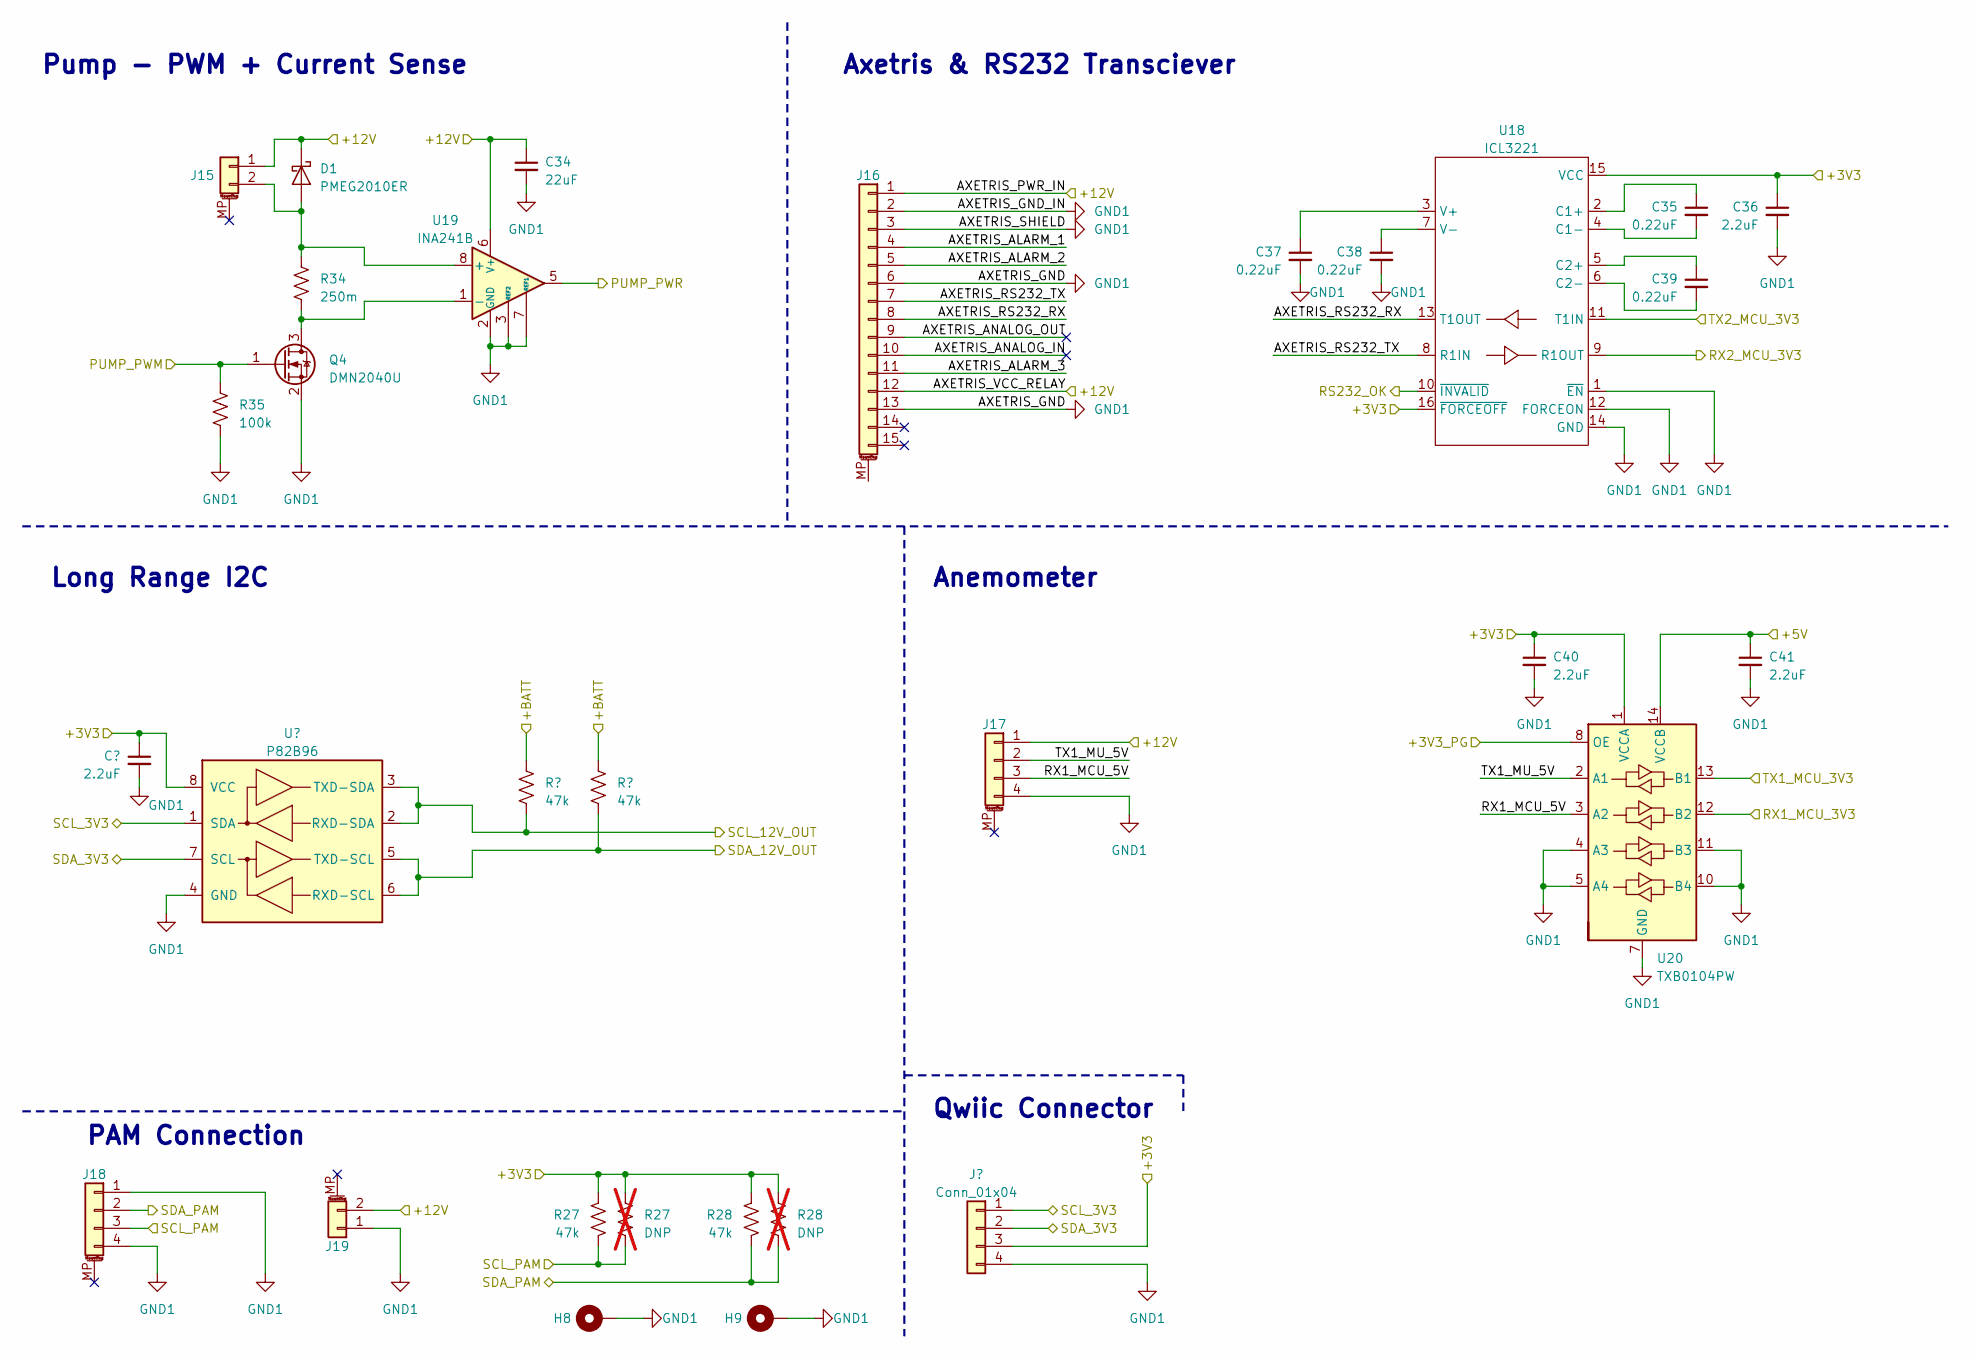
[picture p10: schematic 14_main_remote-devices.kicad_sch]

Parts:
C25, C36, C40, C41: 2.2uF; C_0805_2012Metric_Pad1.18x1.45mm_HandSolder; MPN CL21B225KPFNNNE; DigiKey PN 1276-1188-1-ND
C34: 22uF; CP_Radial_D6.3mm_P2.50mm; MPN EEA-GA1H2R2H; DigiKey PN P15835CT-ND
C35, C37, C38, C39: 0.22uF; C_0805_2012Metric_Pad1.18x1.45mm_HandSolder; MPN CL21B224KAFNNNE; DigiKey PN 1276-1161-1-ND
D1: PMEG2010ER; Nexperia_CFP3_SOD-123W; MPN PMEG2010ER,115; DigiKey PN 1727-5192-1-ND
H8, H9: MountingHole_Pad; MountingHole_3.2mm_M3_DIN965_Pad
J15, J19: Conn_01x02_MountingPin; JST_XH_B2B-XH-AM_1x02_P2.50mm_Vertical; MPN B2B-XH-AM(LF)(SN); DigiKey PN 455-2273-ND
J16: Conn_01x15_MountingPin; DSUB-15_Female_Vertical_P2.77x2.84mm_MountingHoles; MPN D15S24A4GV00LF; DigiKey PN 609-1497-ND
J17, J18: Conn_01x04_MountingPin; JST_XH_B4B-XH-AM_1x04_P2.50mm_Vertical; MPN B4B-XH-AM(LF)(SN); DigiKey PN 455-2237-ND
J22: Conn_01x04; JST_SH_BM04B-SRSS-TB_1x04-1MP_P1.00mm_Vertical; MPN BM04B-SRSS-TB(LF)(SN); DigiKey PN 455-1790-1-ND
Q4: DMN2040U; SOT-523; MPN DMN2040U-13; DigiKey PN 31-DMN2040U-13CT-ND
R27: 47k; R_0805_2012Metric_Pad1.20x1.40mm_HandSolder; MPN RC0805FR-0747KL; DigiKey PN 311-47.0KCRCT-ND
R28, R29: 47k; R_Axial_DIN0207_L6.3mm_D2.5mm_P10.16mm_Horizontal; MPN MFR-25FRF52-47K; DigiKey PN 13-MFR-25FRF52-47KCT-ND
R34: 250m; R_2512_6332Metric_Pad1.40x3.35mm_HandSolder; MPN RL2512FK-070R25L; DigiKey PN 13-RL2512FK-070R25LCT-ND
R35: 100k; R_0805_2012Metric_Pad1.20x1.40mm_HandSolder; MPN RC0805FR-07100KL; DigiKey PN 311-100KCRCT-ND
U15: P82B96; SOIC-8_3.9x4.9mm_P1.27mm; MPN P82B96DR; DigiKey PN 296-20942-1-ND
U18: ICL3221; TSSOP-16_4.4x5mm_P0.65mm; MPN ICL3221ECVZ-T; DigiKey PN ICL3221ECVZ-TCT-ND
U19: INA241B; SOIC-8_3.9x4.9mm_P1.27mm; MPN INA241B1IDDFR; DigiKey PN 296-INA241B1IDDFRCT-ND
U20: TXB0104PW; TSSOP-14_4.4x5mm_P0.65mm; MPN TXB0104PWR; DigiKey PN 296-21929-1-ND

Connections:
+3V3: C25.1, C36.1, C40.1, J22.3, R27.1, R28.1, U15.8 (VCC), U18.15 (VCC), U18.16 (~FORCEOFF), U20.1 (VCCA)
+3V3_PG: U20.8 (OE)
+5V: C41.1, U20.14 (VCCB)
+12V: C34.1, D1.1 (K), J15.1, J16.1, J16.12, J17.1, J19.2, U19.6 (V+)
+BATT: R28.1, R29.1
AXETRIS_ALARM_1: J16.4
AXETRIS_ALARM_2: J16.5
AXETRIS_ALARM_3: J16.11
AXETRIS_ANALOG_IN: J16.10
AXETRIS_ANALOG_OUT: J16.9
AXETRIS_RS232_RX: J16.8, U18.13 (T1OUT)
AXETRIS_RS232_TX: J16.7, U18.8 (R1IN)
GND1: C25.2, C34.2, C36.2, C37.2, C38.2, C40.2, C41.2, H8.1, H9.1, J16.2, J16.3, J16.6, J16.13, J17.4, J18.1, J18.4, J19.1, J22.4, Q4.2 (S), R35.2, U15.4 (GND), U18.1 (~EN), U18.12 (FORCEON), U18.14 (GND), U19.2 (GND), U19.3 (REF2), U19.4 (GND), U19.7 (REF1), U20.4 (A3), U20.5 (A4), U20.7 (GND), U20.10 (B4), U20.11 (B3)
unnamed: C35.1, U18.2 (C1+)
unnamed: C35.2, U18.4 (C1-)
unnamed: C37.1, U18.3 (V+)
unnamed: C38.1, U18.7 (V-)
unnamed: C39.1, U18.5 (C2+)
unnamed: C39.2, U18.6 (C2-)
unnamed: D1.2 (A), J15.2, R34.1, U19.8 (+)
unnamed: Q4.3 (D), R34.2, U19.1 (-)
PUMP_PWM: Q4.1 (G), R35.1
PUMP_PWR: U19.5
RS232_OK: U18.10 (~INVALID)
RX1_MCU_3V3: U20.12 (B2)
RX1_MCU_5V: J17.3, U20.3 (A2)
RX2_MCU_3V3: U18.9 (R1OUT)
SCL_3V3: J22.1, U15.1 (SDA)
SCL_12V_OUT: R28.2, U15.2 (RXD-SDA), U15.3 (TXD-SDA)
SCL_PAM: J18.3, R27.2
SDA_3V3: J22.2, U15.7 (SCL)
SDA_12V_OUT: R29.2, U15.5 (TXD-SCL), U15.6 (RXD-SCL)
SDA_PAM: J18.2, R28.2
TX1_MCU_3V3: U20.13 (B1)
TX1_MU_5V: J17.2, U20.2 (A1)
TX2_MCU_3V3: U18.11 (T1IN)

Notes on the sheet:
Anemometer
PAM Connection
Qwiic Connector
Long Range I2C
Axetris & RS232 Transciever
Pump - PWM + Current Sense
