QuantumMatter/Rumission/Hardware/Daughter Boards/dboards-02/15_main_modular.kicad_sch

## KiCad design Hardware/Daughter Boards/dboards-02/15_main_modular.kicad_sch (2023-12-21)

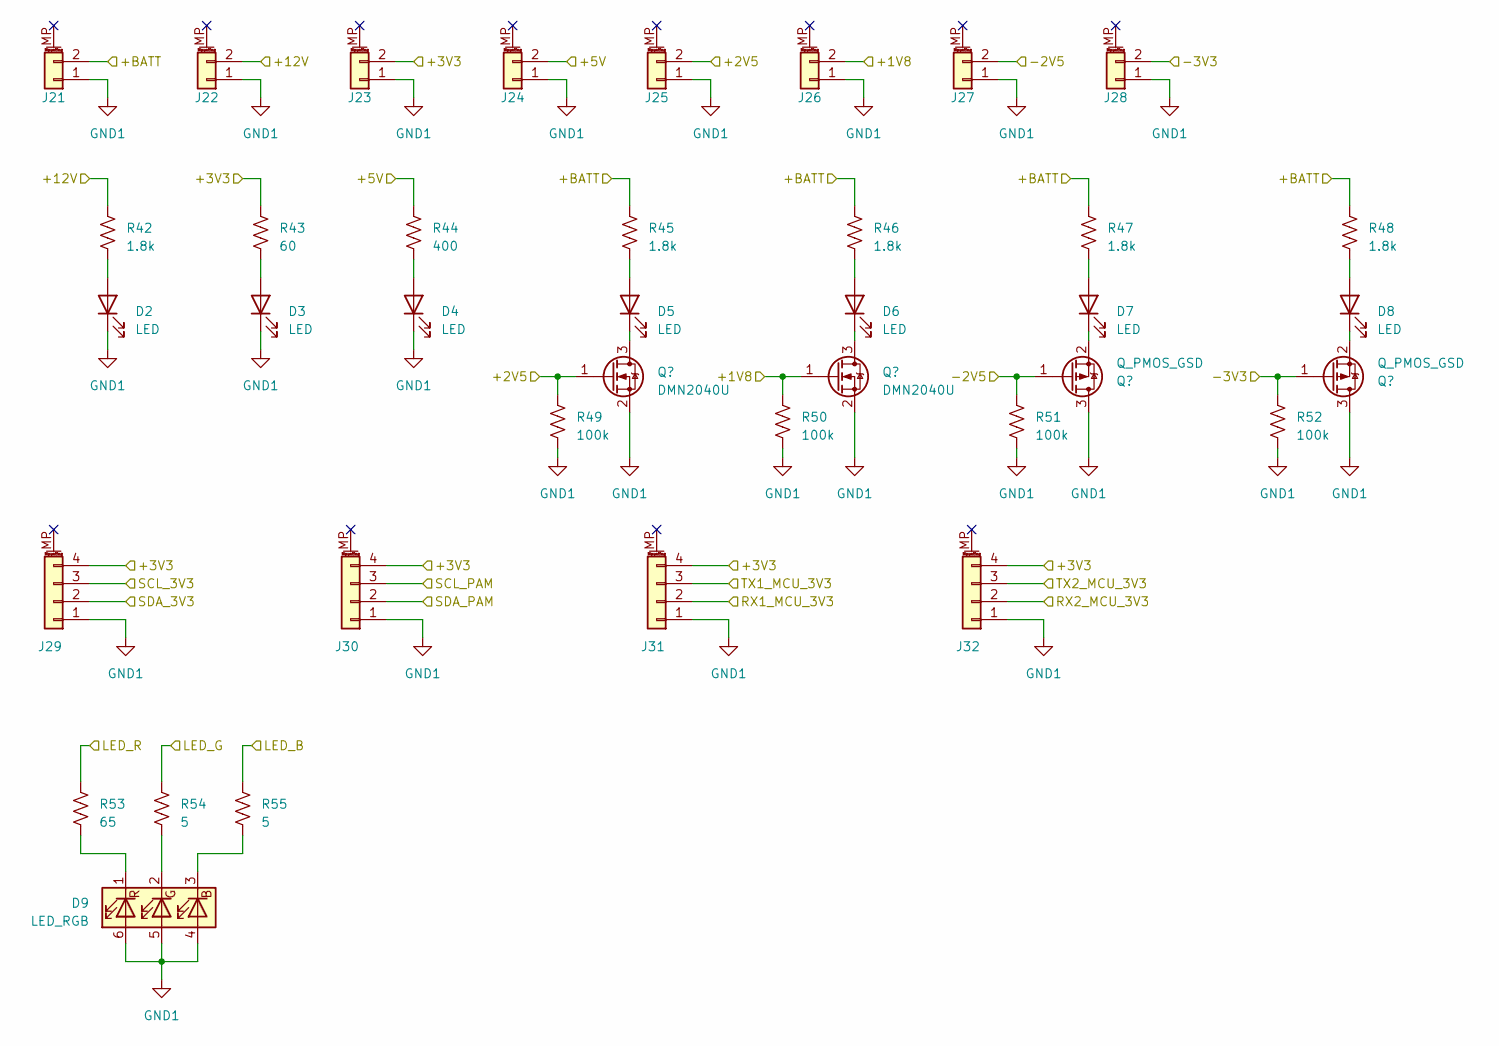
[picture p11: schematic 15_main_modular.kicad_sch]

Parts:
D2, D3, D4, D5, D6, D7, D8: LED; LED_0603_1608Metric_Pad1.05x0.95mm_HandSolder; MPN LTST-C193TGKT-5A; DigiKey PN 160-1832-2-ND
D9: LED_RGB; LED_RGB_Cree-PLCC-6_6x5mm_P2.1mm; MPN CLP6C-FKB-CKNPRGJBB7A363; DigiKey PN CLP6C-FKB-CKNPRGJBB7A363TR-ND
J21, J22, J23, J24, J25, J26, J27, J28: Conn_01x02_MountingPin; JST_XH_B2B-XH-AM_1x02_P2.50mm_Vertical; MPN B2B-XH-AM(LF)(SN); DigiKey PN 455-2273-ND
J29, J30, J31, J32: Conn_01x04_MountingPin; JST_XH_B4B-XH-AM_1x04_P2.50mm_Vertical; MPN B4B-XH-AM(LF)(SN); DigiKey PN 455-2237-ND
Q5: Q_PMOS_GSD; SOT-523; MPN DMP21D0UT-7; DigiKey PN DMP21D0UT-7DITR-ND
Q6: DMN2040U; SOT-523; MPN DMN2040U-13; DigiKey PN 31-DMN2040U-13CT-ND
R42, R45, R46, R47, R48: 1.8k; R_Axial_DIN0207_L6.3mm_D2.5mm_P10.16mm_Horizontal; MPN MFR-25FTE52-1K8; DigiKey PN 13-MFR-25FTE52-1K8CT-ND
R43: 60; R_Axial_DIN0207_L6.3mm_D2.5mm_P10.16mm_Horizontal; MPN MFR-25FTE52-59R; DigiKey PN 13-MFR-25FTE52-59RCT-ND
R44: 400; R_Axial_DIN0207_L6.3mm_D2.5mm_P10.16mm_Horizontal; MPN MFR-25FRF52-402R; DigiKey PN 13-MFR-25FRF52-402RCT-ND
R49, R50, R51, R52: 100k; R_0805_2012Metric_Pad1.20x1.40mm_HandSolder; MPN RC0805FR-07100KL; DigiKey PN 311-100KCRCT-ND
R53: 65; R_Axial_DIN0207_L6.3mm_D2.5mm_P10.16mm_Horizontal; MPN MFR-25FTE52-59R; DigiKey PN 13-MFR-25FTE52-59RCT-ND
R54, R55: 5; R_Axial_DIN0207_L6.3mm_D2.5mm_P10.16mm_Horizontal; MPN MFR-25FTE52-5R1; DigiKey PN 13-MFR-25FTE52-5R1CT-ND

Connections:
+1V8: J26.2, Q6.1 (G), R50.1
+2V5: J25.2, Q6.1 (G), R49.1
+3V3: J23.2, J29.4, J30.4, J31.4, J32.4, R43.1
+5V: J24.2, R44.1
+12V: J22.2, R42.1
+BATT: J21.2, R45.1, R46.1, R47.1, R48.1
-2V5: J27.2, Q5.1 (G), R51.1
-3V3: J28.2, Q5.1 (G), R52.1
GND1: D2.1 (K), D3.1 (K), D4.1 (K), D9.4 (BA), D9.5 (GA), D9.6 (RA), J21.1, J22.1, J23.1, J24.1, J25.1, J26.1, J27.1, J28.1, J29.1, J30.1, J31.1, J32.1, Q5.3 (D), Q6.2 (S), R49.2, R50.2, R51.2, R52.2
LED_B: R55.1
LED_G: R54.1
LED_R: R53.1
unnamed: D2.2 (A), R42.2
unnamed: D3.2 (A), R43.2
unnamed: D4.2 (A), R44.2
unnamed: D5.1 (K), Q6.3 (D)
unnamed: D5.2 (A), R45.2
unnamed: D6.1 (K), Q6.3 (D)
unnamed: D6.2 (A), R46.2
unnamed: D7.1 (K), Q5.2 (S)
unnamed: D7.2 (A), R47.2
unnamed: D8.1 (K), Q5.2 (S)
unnamed: D8.2 (A), R48.2
unnamed: D9.1 (RK), R53.2
unnamed: D9.2 (GK), R54.2
unnamed: D9.3 (BK), R55.2
RX1_MCU_3V3: J31.2
RX2_MCU_3V3: J32.2
SCL_3V3: J29.3
SCL_PAM: J30.3
SDA_3V3: J29.2
SDA_PAM: J30.2
TX1_MCU_3V3: J31.3
TX2_MCU_3V3: J32.3
