QuantumMatter/Rumission/Hardware/Daughter Boards/dboards-02/21_power_battery.kicad_sch

## KiCad design Hardware/Daughter Boards/dboards-02/21_power_battery.kicad_sch (2023-12-21)

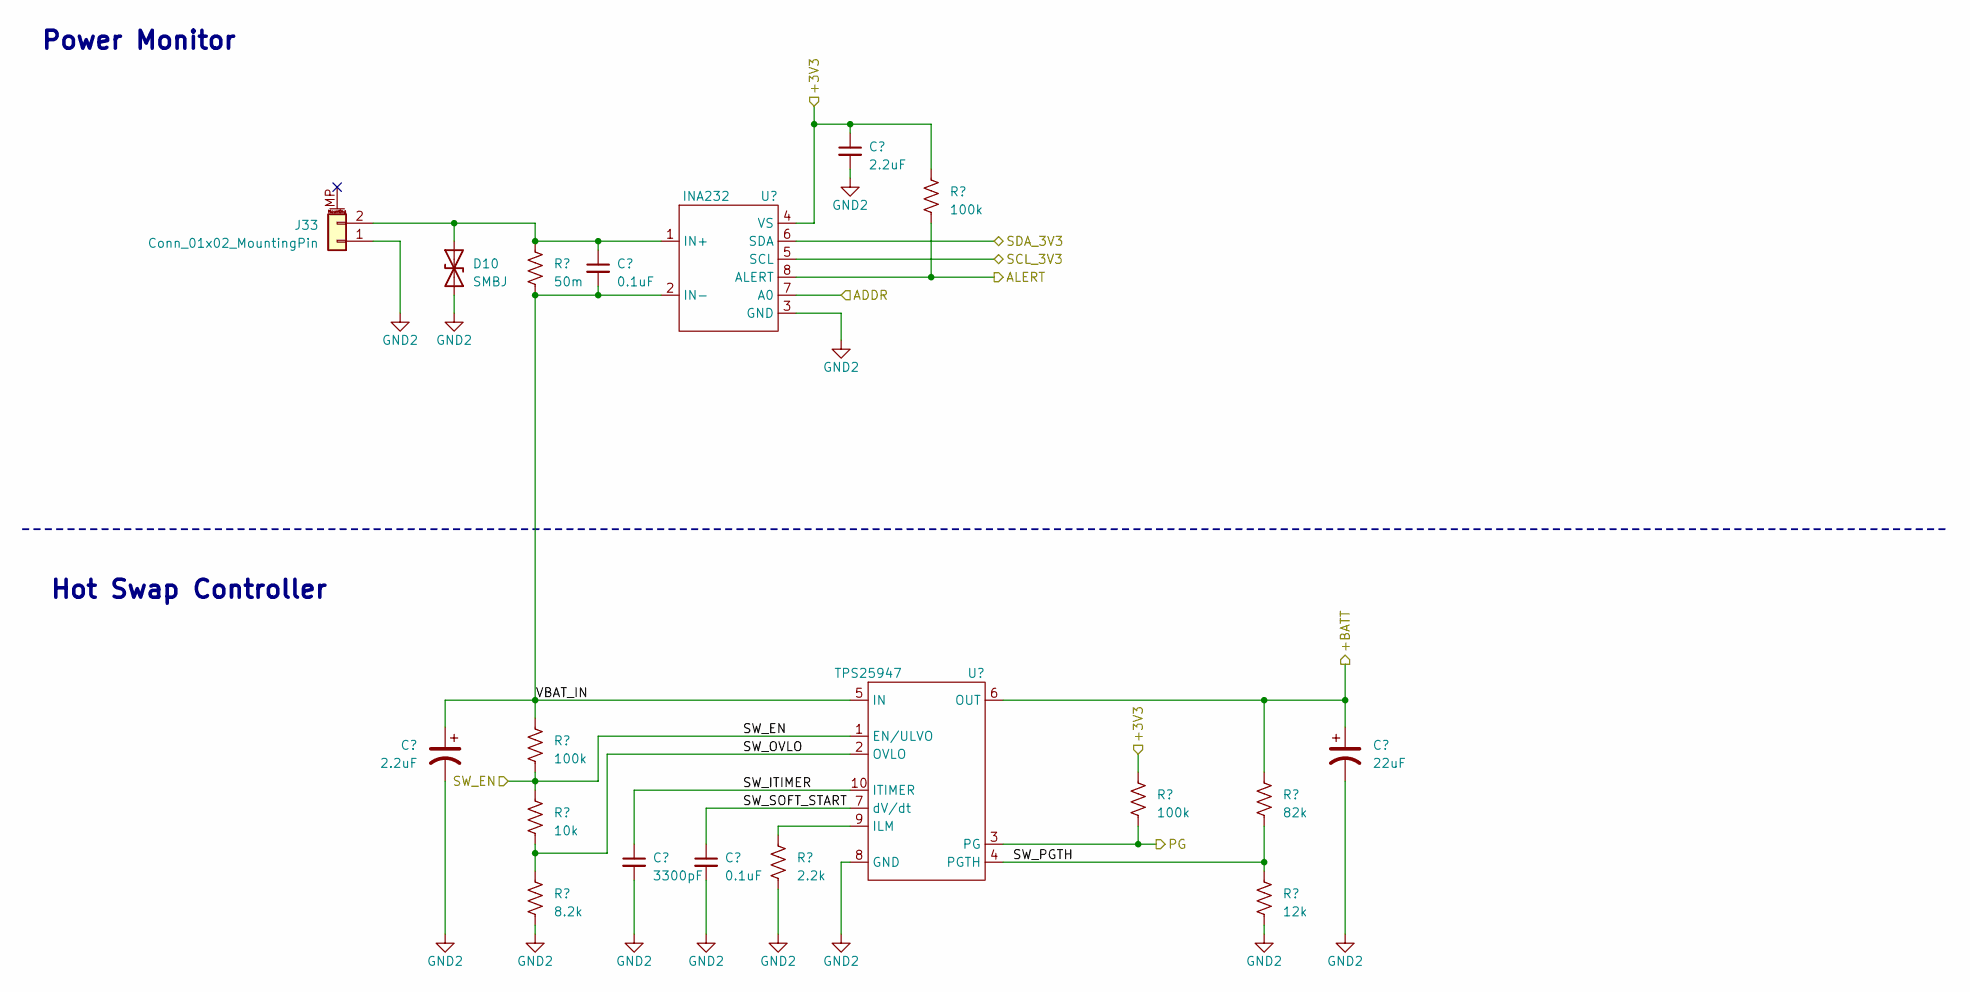
[picture p12: schematic 21_power_battery.kicad_sch]

Parts:
C43: 2.2uF; C_0805_2012Metric_Pad1.18x1.45mm_HandSolder; MPN CL21B225KPFNNNE; DigiKey PN 1276-1188-1-ND
C44, C48: 0.1uF; C_Disc_D5.0mm_W2.5mm_P5.00mm; MPN FA28X8R1E104KNU00; DigiKey PN 445-181217-ND
C45: 2.2uF; CP_Radial_D5.0mm_P2.00mm; MPN ESK225M100AC3AA; DigiKey PN 399-18273-ND
C46: 22uF; CP_Radial_D5.0mm_P2.00mm; MPN 860160372003; DigiKey PN 732-9456-1-ND
C47: 3300pF; C_Disc_D5.0mm_W2.5mm_P5.00mm; MPN FA28X7R1H332KNU06; DigiKey PN 445-180803-1-ND
D10: SMBJ; D_SMB_Handsoldering; MPN SMBJ15A-13-F; DigiKey PN SMBJ15A-FDICT-ND
J33: Conn_01x02_MountingPin; JST_XH_B2B-XH-AM_1x02_P2.50mm_Vertical; MPN B2B-XH-AM(LF)(SN); DigiKey PN 455-2273-ND
R56: 100k; R_0805_2012Metric_Pad1.20x1.40mm_HandSolder; MPN RC0805FR-07100KL; DigiKey PN 311-100KCRCT-ND
R57: 50m; R_2512_6332Metric_Pad1.40x3.35mm_HandSolder; MPN 13-PA2512FKE070R05ECT-ND; DigiKey PN PA2512FKE070R05E
R58: 100k; R_Axial_DIN0207_L6.3mm_D2.5mm_P10.16mm_Horizontal; MPN MFR-25FRF52-100K; DigiKey PN 13-MFR-25FRF52-100KCT-ND
R59: 100k; R_Axial_DIN0207_L6.3mm_D2.5mm_P10.16mm_Horizontal; MPN MFR-25FRF52-47K; DigiKey PN 13-MFR-25FRF52-47KCT-ND
R60: 82k; R_Axial_DIN0207_L6.3mm_D2.5mm_P10.16mm_Horizontal; MPN MFR-25FRF52-82K; DigiKey PN 13-MFR-25FRF52-82KTR-ND
R61: 10k; R_Axial_DIN0207_L6.3mm_D2.5mm_P10.16mm_Horizontal; MPN MFR-25FRF52-10K; DigiKey PN 13-MFR-25FRF52-10KCT-ND
R62: 2.2k; R_Axial_DIN0207_L6.3mm_D2.5mm_P10.16mm_Horizontal; MPN MFR-25FRF52-2K2; DigiKey PN 13-MFR-25FRF52-2K2CT-ND
R63: 8.2k; R_Axial_DIN0207_L6.3mm_D2.5mm_P10.16mm_Horizontal; MPN MFR-25FRF52-8K2; DigiKey PN 13-MFR-25FRF52-8K2CT-ND
R64: 12k; R_Axial_DIN0207_L6.3mm_D2.5mm_P10.16mm_Horizontal; MPN MFR-25FRF52-12K; DigiKey PN 13-MFR-25FRF52-12KCT-ND
U22: INA232; SOT-23-TI; MPN INA232AIDDFR; DigiKey PN 296-INA232AIDDFRCT-ND
U23: TPS25947; SOT-23-TI_1; MPN TPS259474LRPW; DigiKey PN 296-TPS259474LRPWRCT-ND

Connections:
+3V3: C43.1, R56.1, R59.1, U22.4 (VS)
+BATT: C46.1, R60.1, U23.6 (OUT)
ADDR: U22.7 (A0)
ALERT: R56.2, U22.8 (ALERT)
GND2: C43.2, C45.2, C46.2, C47.2, C48.2, D10.1 (A1), J33.1, R62.2, R63.2, R64.2, U22.3 (GND), U23.8 (GND)
unnamed: C44.1, D10.2 (A2), J33.2, R57.1, U22.1 (IN+)
unnamed: R62.1, U23.9 (ILM)
PG: R59.2, U23.3 (PG)
SCL_3V3: U22.5 (SCL)
SDA_3V3: U22.6 (SDA)
SW_EN: R58.2, R61.1, U23.1 (EN/ULVO)
SW_ITIMER: C47.1, U23.10 (ITIMER)
SW_OVLO: R61.2, R63.1, U23.2 (OVLO)
SW_PGTH: R60.2, R64.1, U23.4 (PGTH)
SW_SOFT_START: C48.1, U23.7 (dV/dt)
VBAT_IN: C44.2, C45.1, R57.2, R58.1, U22.2 (IN-), U23.5 (IN)

Notes on the sheet:
Hot Swap Controller
Power Monitor
