QuantumMatter/Rumission/Hardware/Daughter Boards/dboards-02/22_power_connectors.kicad_sch

## KiCad design Hardware/Daughter Boards/dboards-02/22_power_connectors.kicad_sch (2023-12-21)

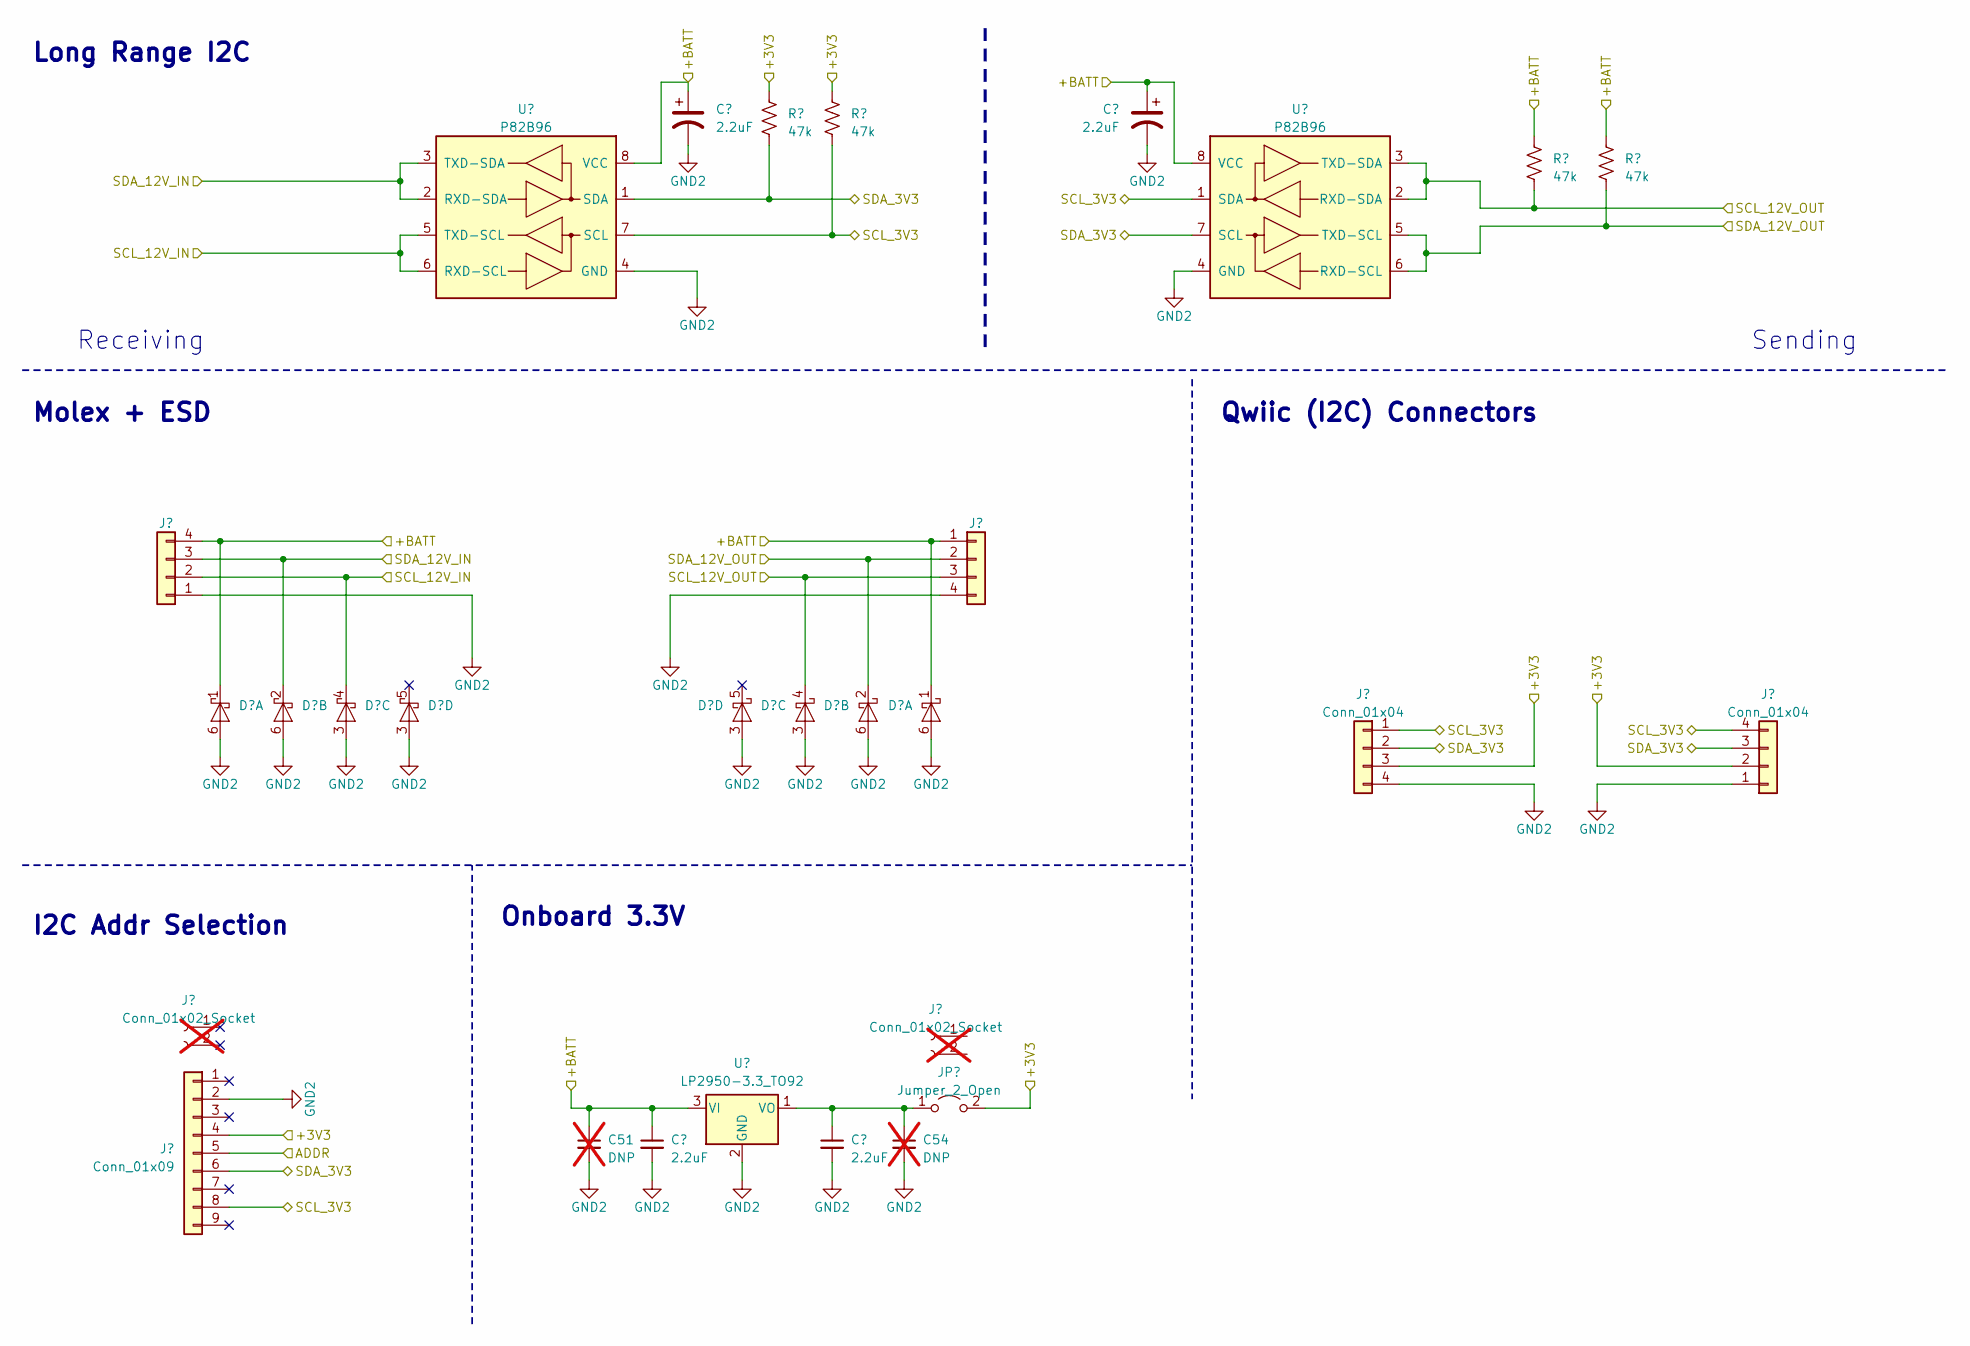
[picture p13: schematic 22_power_connectors.kicad_sch]

Parts:
C45: 2.2uF; CP_Radial_D5.0mm_P2.00mm; MPN ESK225M100AC3AA; DigiKey PN 399-18273-ND
C51, C54: DNP; C_Disc_D5.0mm_W2.5mm_P5.00mm; not fitted
C52, C53: 2.2uF; C_0805_2012Metric_Pad1.18x1.45mm_HandSolder; MPN CL21B225KPFNNNE; DigiKey PN 1276-1188-1-ND
D15, D16: BAT54ADW; SOT-363_SC-70-6; MPN BAT54ADW-7-F; DigiKey PN BAT54ADW-FDICT-ND
J35, J36: Conn_01x04_MountingPin; PinHeader_1x04_P2.54mm_Vertical; MPN 0022284045; DigiKey PN 900-0022284045-ND
J37, J38: Conn_01x04; JST_SH_BM04B-SRSS-TB_1x04-1MP_P1.00mm_Vertical; MPN BM04B-SRSS-TB(LF)(SN); DigiKey PN 455-1790-1-ND
J39, J40: Conn_01x02_Socket; JWT_A3963_1x02_P3.96mm_Vertical; MPN QPC02SXGN-RC; DigiKey PN S9337-ND; not fitted
J41: Conn_01x09; PinHeader_2x02_P2.54mm_Vertical; MPN TSW-103-07-G-T; DigiKey PN SAM10328-ND
JP2: Jumper_2_Open; PinHeader_1x02_P2.54mm_Vertical; MPN 77311-118-02LF; DigiKey PN 609-4434-ND
R69, R70, R71, R72: 47k; R_Axial_DIN0207_L6.3mm_D2.5mm_P10.16mm_Horizontal; MPN MFR-25FRF52-47K; DigiKey PN 13-MFR-25FRF52-47KCT-ND
U24, U25: P82B96; SOIC-8_3.9x4.9mm_P1.27mm; MPN P82B96DR; DigiKey PN 296-20942-1-ND
U26: LP2950-3.3_TO92; TO-92_Inline_Wide(r); MPN LP2950-33LPRE3; DigiKey PN 296-31455-2-ND

Connections:
+3V3: J37.3, J38.2, J41.4, JP2.2 (B), R69.1, R70.1
+BATT: C45.1, C51.1, C52.1, D15.1 (K), D16.1 (K), J35.1, J36.4, R71.1, R72.1, U24.8 (VCC), U25.8 (VCC), U26.3 (VI)
ADDR: J41.5
GND2: C45.2, C51.2, C52.2, C53.2, C54.2, D15.3 (A), D15.6 (A), D16.3 (A), D16.6 (A), J35.4, J36.1, J37.4, J38.1, J41.2, U24.4 (GND), U25.4 (GND), U26.2 (GND)
unnamed: C53.1, C54.1, JP2.1 (A), U26.1 (VO)
SCL_3V3: J37.1, J38.4, J41.8, R70.2, U24.7 (SCL), U25.1 (SDA)
SCL_12V_IN: D15.4 (K), J36.2, U24.5 (TXD-SCL), U24.6 (RXD-SCL)
SCL_12V_OUT: D16.4 (K), J35.3, R71.2, U25.2 (RXD-SDA), U25.3 (TXD-SDA)
SDA_3V3: J37.2, J38.3, J41.6, R69.2, U24.1 (SDA), U25.7 (SCL)
SDA_12V_IN: D15.2 (K), J36.3, U24.2 (RXD-SDA), U24.3 (TXD-SDA)
SDA_12V_OUT: D16.2 (K), J35.2, R72.2, U25.5 (TXD-SCL), U25.6 (RXD-SCL)

Notes on the sheet:
Sending
Long Range I2C
Molex + ESD
I2C Addr Selection
Qwiic (I2C) Connectors
Receiving
Onboard 3.3V
