QuantumMatter/Rumission/Hardware/Daughter Boards/dboards-02/22_power_indicators.kicad_sch

## KiCad design Hardware/Daughter Boards/dboards-02/22_power_indicators.kicad_sch (2023-12-21)

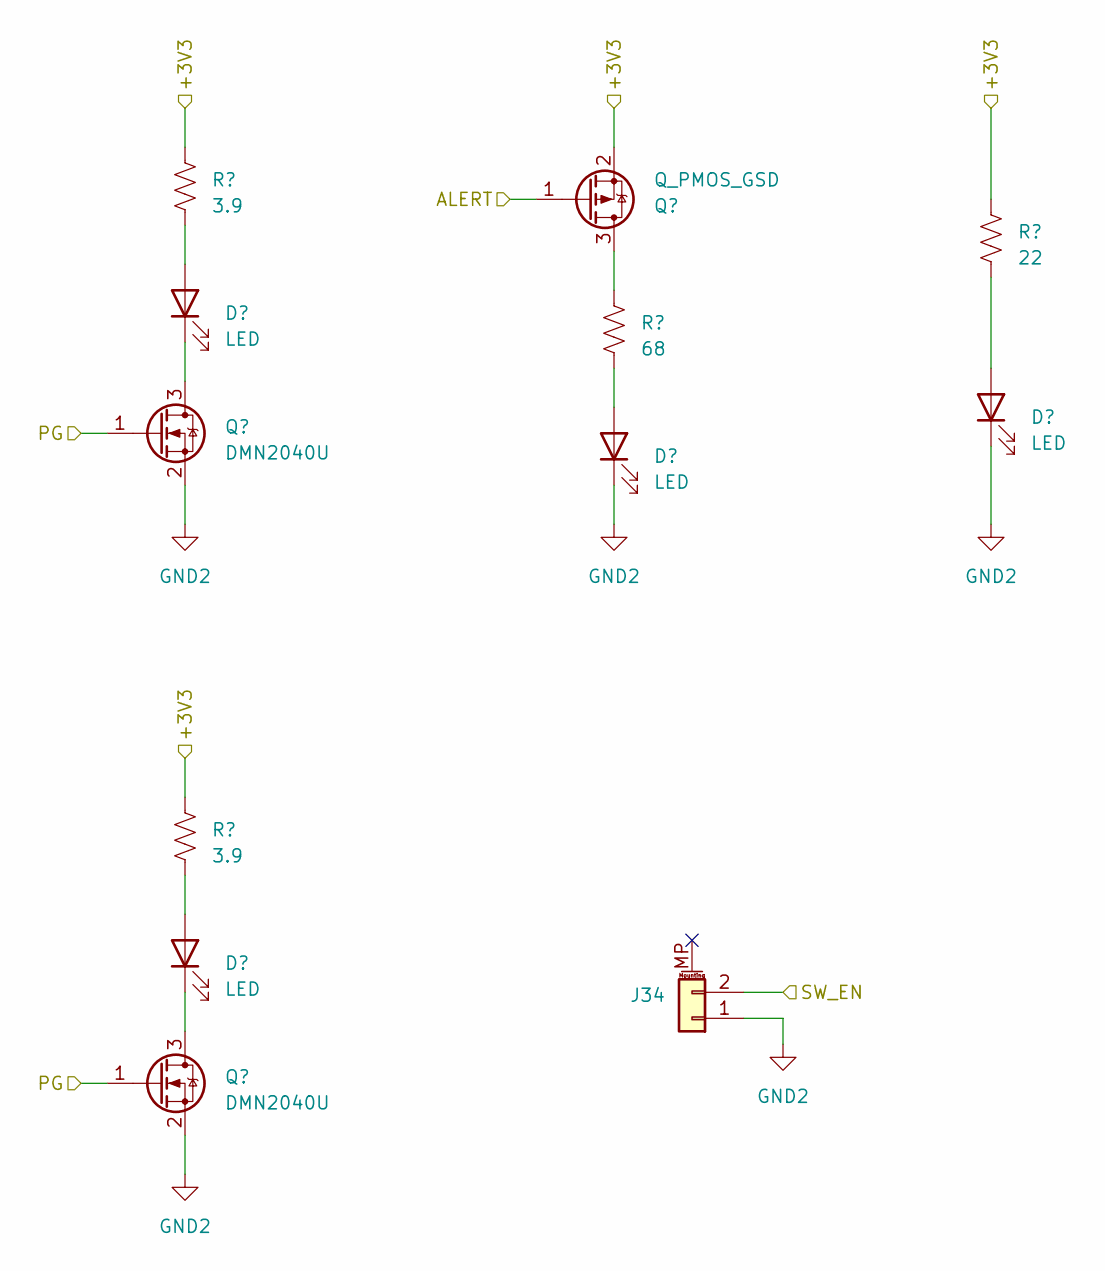
[picture p14: schematic 22_power_indicators.kicad_sch]

Parts:
D11, D14: LED; LED_D5.0mm; MPN C503B-GCN-CY0C0792; DigiKey PN C503B-GCN-CY0C0792CT-ND
D12: LED; LED_PLCC-2_3.4x3.0mm_AK; MPN CLM1B-BKW-CTBVA353; DigiKey PN CLM1B-BKW-CTBVA353CT-ND
D13: LED; LED_D5.0mm; MPN C503B-RAN-CA0B0AA1; DigiKey PN C503B-RAN-CA0B0AA1-ND
J34: Conn_01x02_MountingPin; JST_XH_B2B-XH-AM_1x02_P2.50mm_Vertical; MPN B2B-XH-AM(LF)(SN); DigiKey PN 455-2273-ND
Q9: Q_PMOS_GSD; SOT-523; MPN DMP21D0UT-7; DigiKey PN DMP21D0UT-7DITR-ND
Q10, Q11: DMN2040U; SOT-523; MPN DMN2040U-13; DigiKey PN 31-DMN2040U-13CT-ND
R65, R68: 3.9; R_Axial_DIN0207_L6.3mm_D2.5mm_P10.16mm_Horizontal; MPN MFR-25FTE52-3R9; DigiKey PN 13-MFR-25FTE52-3R9CT-ND
R66: 22; R_Axial_DIN0207_L6.3mm_D2.5mm_P10.16mm_Horizontal; MPN MFR-25FTE52-22R; DigiKey PN 13-MFR-25FTE52-22RCT-ND
R67: 68; R_Axial_DIN0207_L6.3mm_D2.5mm_P10.16mm_Horizontal; MPN MFR-25FRF52-68R; DigiKey PN 13-MFR-25FRF52-68RCT-ND

Connections:
+3V3: Q9.2 (S), R65.1, R66.1, R68.1
ALERT: Q9.1 (G)
GND2: D12.1 (K), D13.1 (K), J34.1, Q10.2 (S), Q11.2 (S)
unnamed: D11.1 (K), Q10.3 (D)
unnamed: D11.2 (A), R65.2
unnamed: D12.2 (A), R66.2
unnamed: D13.2 (A), R67.2
unnamed: D14.1 (K), Q11.3 (D)
unnamed: D14.2 (A), R68.2
unnamed: Q9.3 (D), R67.1
PG: Q10.1 (G), Q11.1 (G)
SW_EN: J34.2
