QuantumMatter/Rumission/Hardware/Daughter Boards/dboards-02/31_flow_mcu.kicad_sch

## KiCad design Hardware/Daughter Boards/dboards-02/31_flow_mcu.kicad_sch (2023-12-21)

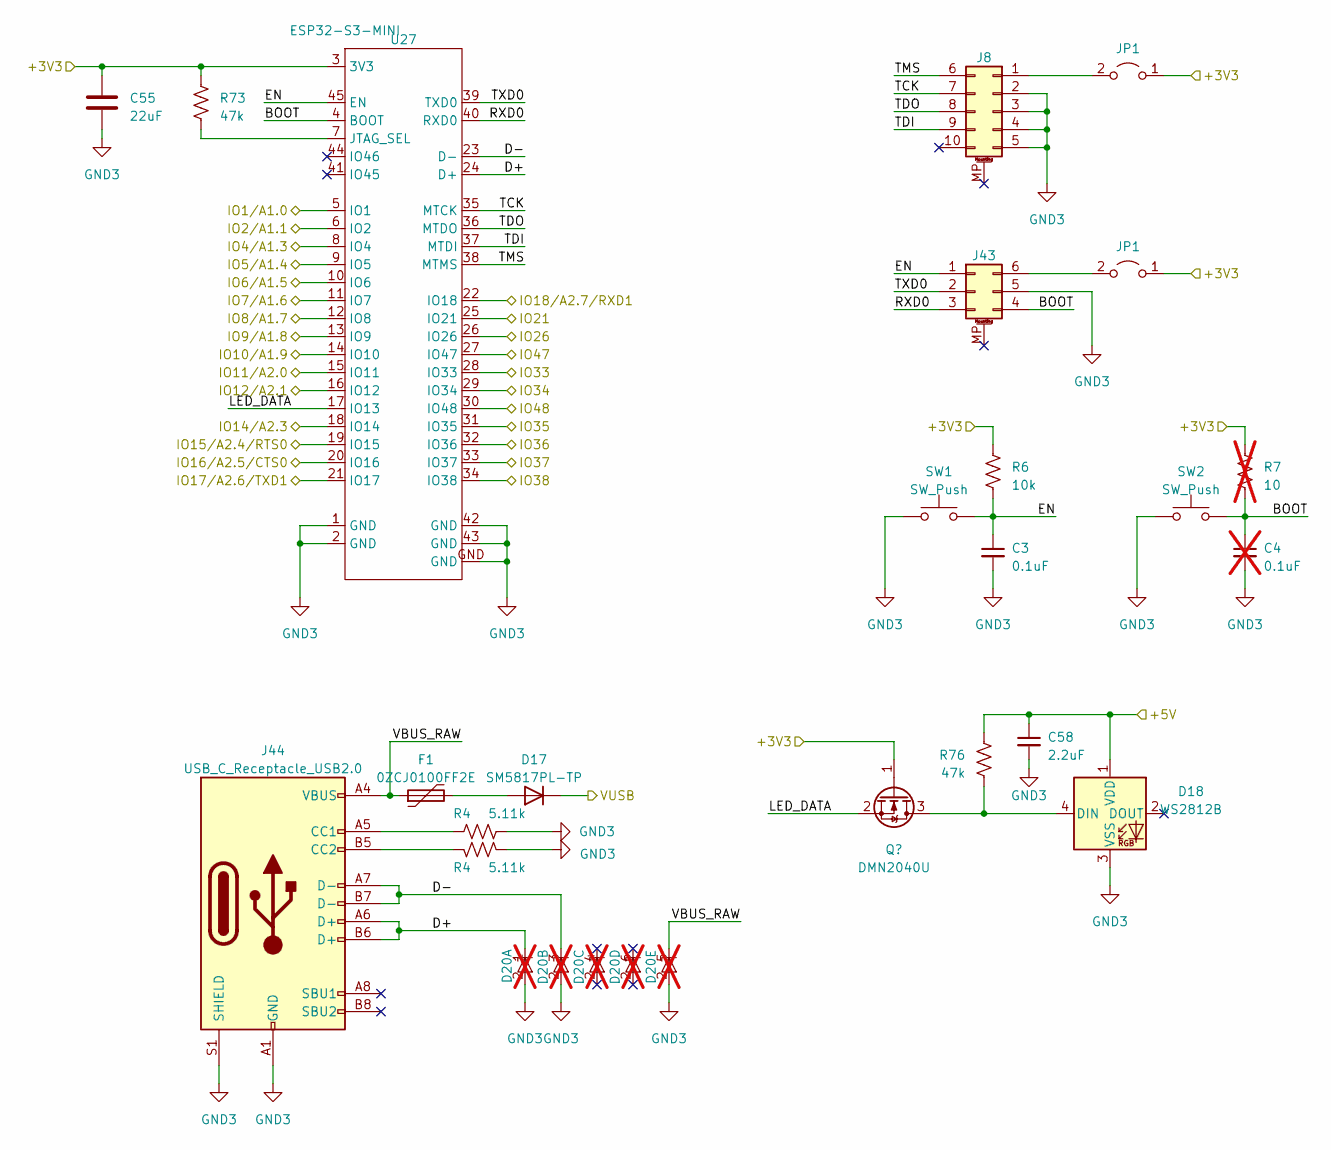
[picture p15: schematic 31_flow_mcu.kicad_sch]

Parts:
C3: 0.1uF; C_Disc_D5.0mm_W2.5mm_P5.00mm; MPN FA28X8R1E104KNU00; DigiKey PN 445-181217-ND
C4: 0.1uF; C_Disc_D5.0mm_W2.5mm_P5.00mm; MPN FA28X8R1E104KNU00; DigiKey PN 445-181217-ND; not fitted
C55: 22uF; C_0805_2012Metric_Pad1.18x1.45mm_HandSolder; MPN CL21A226MOCLRNC; DigiKey PN 1276-6780-1-ND
C58: 2.2uF; C_0805_2012Metric_Pad1.18x1.45mm_HandSolder; MPN CL21B225KPFNNNE; DigiKey PN 1276-1188-1-ND
D17: SM5817PL-TP; D_SOD-123; MPN SM5817PL-TP; DigiKey PN SM5817PL-TPMSCT-ND
D18: WS2812B; LED_WS2812B_PLCC4_5.0x5.0mm_P3.2mm; MPN COM-16347; DigiKey PN 1568-COM-16347CT-ND
D20: D5V0F4U6SO; SOT26; MPN D5V0F4U6SO-7; DigiKey PN D5V0F4U6SO-7DICT-ND; not fitted
F1: 0ZCJ0100FF2E; Fuse_1206_3216Metric_Pad1.42x1.75mm_HandSolder; MPN 0ZCJ0100FF2E; DigiKey PN 507-1806-1-ND
J8: Conn_02x05_Top_Bottom_MountingPin; PinSocket_2x05_P1.27mm_Vertical; MPN 302-S101; DigiKey PN ED1543-ND
J43: Conn_02x03_Counter_Clockwise_MountingPin; PinSocket_2x03_P1.27mm_Vertical; MPN 20021511-00006T4LF; DigiKey PN 20021511-00006T4LF-ND
J44: USB_C_Receptacle_USB2.0; USB_C_Receptacle_Amphenol_12401610E4-2A; MPN 12401610E4#2A; DigiKey PN 12401610E4#2ACT-ND
JP1: Jumper_2_Open; PinHeader_1x02_P2.54mm_Vertical; MPN 77311-118-02LF; DigiKey PN 609-4434-ND
Q10: DMN2040U; SOT-523; MPN DMN2040U-13; DigiKey PN 31-DMN2040U-13CT-ND
R4: 5.11k; R_0805_2012Metric_Pad1.20x1.40mm_HandSolder; MPN RC0805FR-075K11L; DigiKey PN 311-5.11KCRCT-ND
R6: 10k; R_Axial_DIN0207_L6.3mm_D2.5mm_P10.16mm_Horizontal; MPN MFR-25FRF52-10K; DigiKey PN 13-MFR-25FRF52-10KCT-ND
R7: 10; R_Axial_DIN0207_L6.3mm_D2.5mm_P10.16mm_Horizontal; MPN MFR-25FTF52-10R; DigiKey PN 13-MFR-25FTF52-10RCT-ND; not fitted
R73, R76: 47k; R_0805_2012Metric_Pad1.20x1.40mm_HandSolder; MPN RC0805FR-0747KL; DigiKey PN 311-47.0KCRCT-ND
SW1: SW_Push; SW_SPST_PTS645; MPN PTS645SH43SMTR92 LFS; DigiKey PN CKN11907CT-ND
SW2: SW_Push; SW_SPST_PTS645; MPN PTS645SM43SMTR92 LFS; DigiKey PN CKN9112CT-ND
U27: ESP32-S3-MINI; MPN ESP32-S3-MINI-1U-N8; DigiKey PN 1965-ESP32-S3-MINI-1U-N8CT-ND

Connections:
+3V3: C55.1, JP1.1 (A), Q10.1 (G), R6.1, R7.1, R73.1, U27.3 (3V3)
+5V: C58.1, D18.1 (VDD), R76.1
BOOT: C4.1, J43.4, R7.2, SW2.2, U27.4 (BOOT)
D+: D20.1 (K1), J44.A6 (D+), J44.B6 (D+), U27.24 (D+)
D-: D20.3 (K2), J44.A7 (D-), J44.B7 (D-), U27.23 (D-)
EN: C3.1, J43.1, R6.2, SW1.2, U27.45 (EN)
GND3: C3.2, C4.2, C55.2, C58.2, D18.3 (VSS), D20.2 (A), J8.2, J8.3, J8.4, J8.5, J43.5, J44.A1 (GND), J44.A12 (GND), J44.B1 (GND), J44.B12 (GND), J44.S1 (SHIELD), R4.1, SW1.1, SW2.1, U27.1 (GND), U27.2 (GND), U27.42 (GND), U27.43 (GND), U27.GND
IO1/A1.0: U27.5 (IO1)
IO2/A1.1: U27.6 (IO2)
IO4/A1.3: U27.8 (IO4)
IO5/A1.4: U27.9 (IO5)
IO6/A1.5: U27.10 (IO6)
IO7/A1.6: U27.11 (IO7)
IO8/A1.7: U27.12 (IO8)
IO9/A1.8: U27.13 (IO9)
IO10/A1.9: U27.14 (IO10)
IO11/A2.0: U27.15 (IO11)
IO12/A2.1: U27.16 (IO12)
IO14/A2.3: U27.18 (IO14)
IO15/A2.4/RTS0: U27.19 (IO15)
IO16/A2.5/CTS0: U27.20 (IO16)
IO17/A2.6/TXD1: U27.21 (IO17)
IO18/A2.7/RXD1: U27.22 (IO18)
IO21: U27.25 (IO21)
IO26: U27.26 (IO26)
IO33: U27.28 (IO33)
IO34: U27.29 (IO34)
IO35: U27.31 (IO35)
IO36: U27.32 (IO36)
IO37: U27.33 (IO37)
IO38: U27.34 (IO38)
IO47: U27.27 (IO47)
IO48: U27.30 (IO48)
LED_DATA: Q10.2 (S), U27.17 (IO13)
unnamed: D17.2 (A), F1.2
unnamed: D18.4 (DIN), Q10.3 (D), R76.2
unnamed: J8.1, JP1.2 (B)
unnamed: J43.6, JP1.2 (B)
unnamed: J44.A5 (CC1), R4.2
unnamed: J44.B5 (CC2), R4.2
unnamed: R73.2, U27.7 (JTAG_SEL)
RXD0: J43.3, U27.40 (RXD0)
TCK: J8.7, U27.35 (MTCK)
TDI: J8.9, U27.37 (MTDI)
TDO: J8.8, U27.36 (MTDO)
TMS: J8.6, U27.38 (MTMS)
TXD0: J43.2, U27.39 (TXD0)
VBUS_RAW: D20.5 (K_Vcc), F1.1, J44.A4 (VBUS), J44.A9 (VBUS), J44.B4 (VBUS), J44.B9 (VBUS)
VUSB: D17.1 (K)
