QuantumMatter/Rumission/Hardware/Daughter Boards/dboards-02/32_flow_power.kicad_sch

## KiCad design Hardware/Daughter Boards/dboards-02/32_flow_power.kicad_sch (2023-12-21)

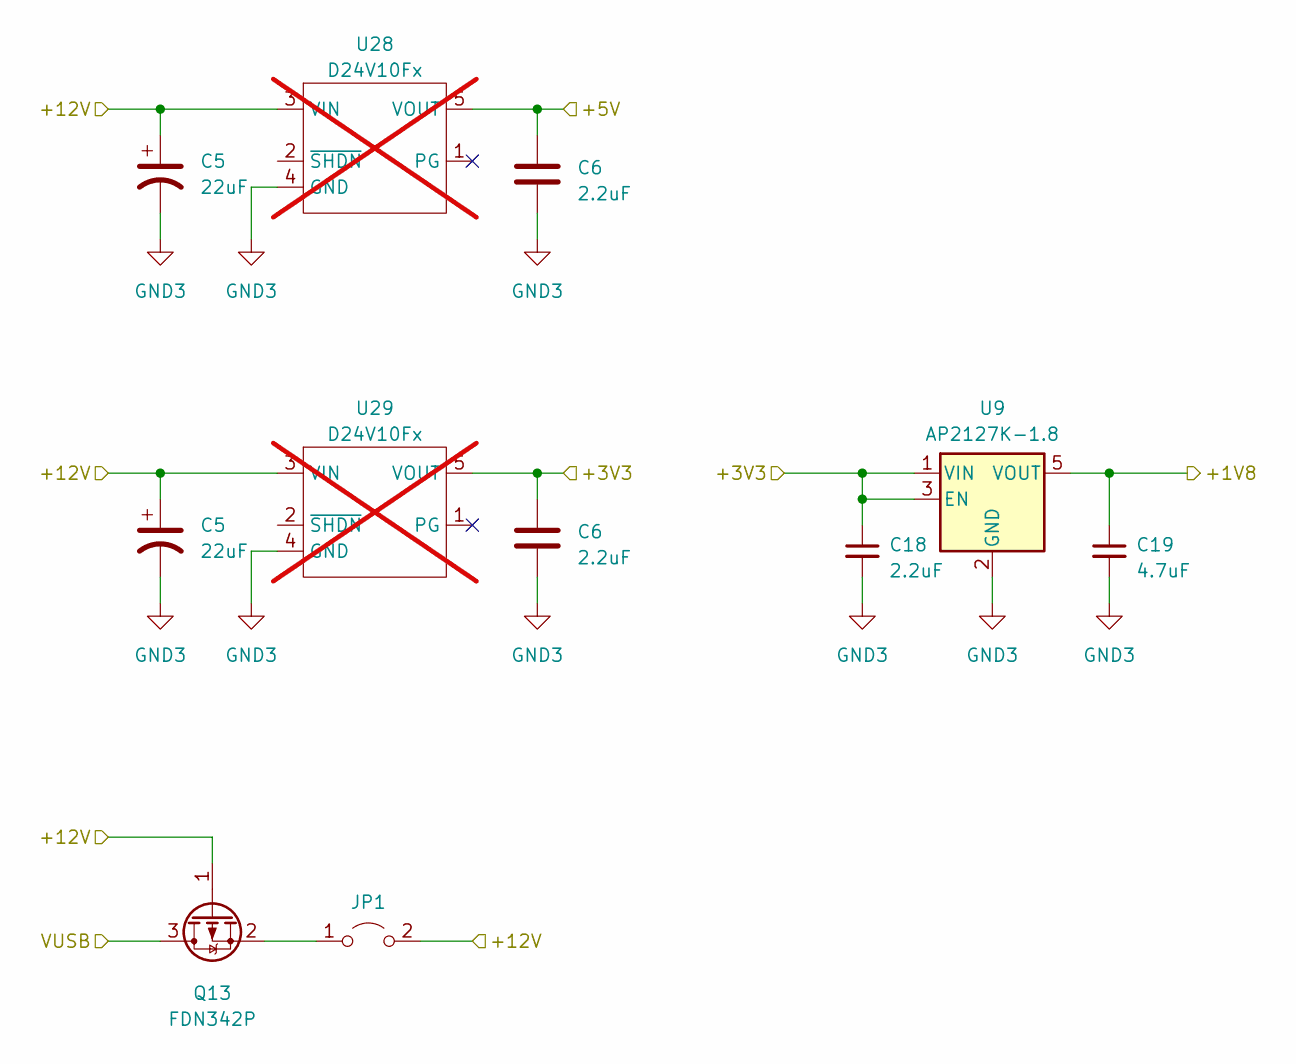
[picture p16: schematic 32_flow_power.kicad_sch]

Parts:
C5: 22uF; CP_Radial_D6.3mm_P2.50mm; MPN EEA-GA1H2R2H; DigiKey PN P15835CT-ND
C6, C18: 2.2uF; C_0805_2012Metric_Pad1.18x1.45mm_HandSolder; MPN CL21B225KPFNNNE; DigiKey PN 1276-1188-1-ND
C19: 4.7uF; C_0805_2012Metric_Pad1.18x1.45mm_HandSolder; MPN CL21A475KAQNNNE; DigiKey PN 1276-1244-1-ND
JP1: Jumper_2_Open; PinHeader_1x02_P2.54mm_Vertical; MPN 77311-118-02LF; DigiKey PN 609-4434-ND
Q13: FDN342P; SOT-23-3; MPN FDN342P; DigiKey PN FDN342PCT-ND
U9: AP2127K-1.8; SOT-23-5; MPN AP2127K-1.8TRG1; DigiKey PN AP2127K-1.8TRG1DICT-ND
U28: D24V10Fx; MPN D24V10F5; not fitted
U29: D24V10Fx; MPN D24V10F3; not fitted

Connections:
+1V8: C19.1, U9.5 (VOUT)
+3V3: C6.1, C18.1, U9.1 (VIN), U9.3 (EN), U29.5 (VOUT)
+5V: C6.1, U28.5 (VOUT)
+12V: C5.1, JP1.2 (B), Q13.1 (G), U28.3 (VIN), U29.3 (VIN)
GND3: C5.2, C6.2, C18.2, C19.2, U9.2 (GND), U28.4 (GND), U29.4 (GND)
unnamed: JP1.1 (A), Q13.2 (S)
VUSB: Q13.3 (D)
