QuantumMatter/Rumission/Hardware/Daughter Boards/dboards-02/33_flow_sensors.kicad_sch

## KiCad design Hardware/Daughter Boards/dboards-02/33_flow_sensors.kicad_sch (2023-12-21)

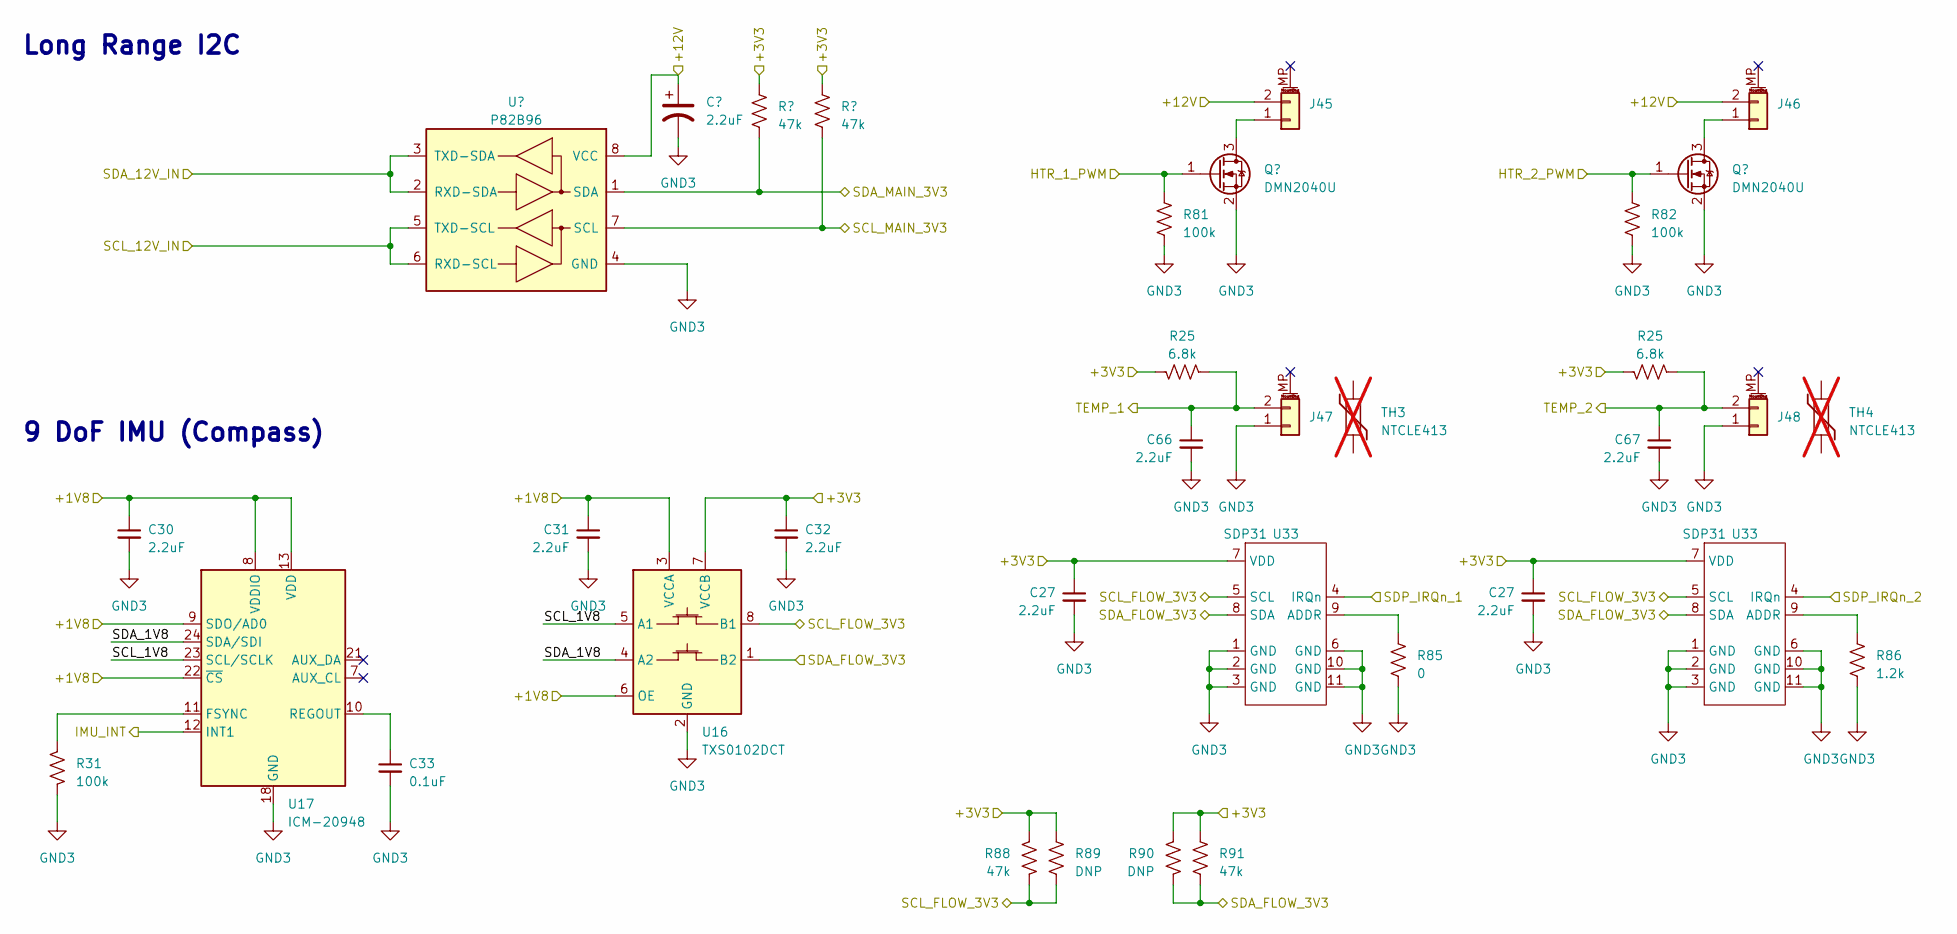
[picture p17: schematic 33_flow_sensors.kicad_sch]

Parts:
C27, C30, C31, C32, C66, C67: 2.2uF; C_0805_2012Metric_Pad1.18x1.45mm_HandSolder; MPN CL21B225KPFNNNE; DigiKey PN 1276-1188-1-ND
C33: 0.1uF; C_0805_2012Metric_Pad1.18x1.45mm_HandSolder; MPN CL21B104KACNNNC; DigiKey PN 1276-1099-1-ND
C45: 2.2uF; CP_Radial_D5.0mm_P2.00mm; MPN ESK225M100AC3AA; DigiKey PN 399-18273-ND
J45, J46, J47, J48: Conn_01x02_MountingPin; JST_XH_B2B-XH-AM_1x02_P2.50mm_Vertical; MPN B2B-XH-AM(LF)(SN); DigiKey PN 455-2273-ND
Q6: DMN2040U; SOT-523; MPN DMN2040U-13; DigiKey PN 31-DMN2040U-13CT-ND
R25: 6.8k; R_Axial_DIN0207_L6.3mm_D2.5mm_P10.16mm_Horizontal; MPN MFR-25FRF52-6K8; DigiKey PN 13-MFR-25FRF52-6K8CT-ND
R31: 100k; R_1206_3216Metric_Pad1.30x1.75mm_HandSolder; MPN RC1206FR-07100KL; DigiKey PN 311-100KFRCT-ND
R67, R68, R88, R91: 47k; R_1206_3216Metric_Pad1.30x1.75mm_HandSolder; MPN RC1206FR-0747KL; DigiKey PN 311-47.0KFRCT-ND
R81, R82: 100k; R_0805_2012Metric_Pad1.20x1.40mm_HandSolder; MPN RC0805FR-07100KL; DigiKey PN 311-100KCRCT-ND
R85: 0; R_0805_2012Metric_Pad1.20x1.40mm_HandSolder; MPN RC0805JR-070RL; DigiKey PN 311-0.0ARCT-ND
R86: 1.2k; R_0805_2012Metric_Pad1.20x1.40mm_HandSolder; MPN RC0805FR-071K2L; DigiKey PN 311-1.20KCRCT-ND
R89, R90: DNP; R_Axial_DIN0207_L6.3mm_D2.5mm_P10.16mm_Horizontal
TH3, TH4: NTCLE413; MPN NTCLE413E2103F102L; DigiKey PN BC2647-ND; not fitted
U16: TXS0102DCT; SSOP-8_2.95x2.8mm_P0.65mm; MPN TXS0102DCTR; DigiKey PN 296-21978-1-ND
U17: ICM-20948; InvenSense_QFN-24_3x3mm_P0.4mm; MPN ICM-20948; DigiKey PN 1428-1123-1-ND
U24: P82B96; SOIC-8_3.9x4.9mm_P1.27mm; MPN P82B96DR; DigiKey PN 296-20942-1-ND
U33: SDP31; DigiKey PN D5V0F4U6SO-7DICT-ND

Connections:
+1V8: C30.1, C31.1, U16.3 (VCCA), U16.6 (OE), U17.8 (VDDIO), U17.9 (SDO/AD0), U17.13 (VDD), U17.22 (~CS)
+3V3: C27.1, C32.1, R25.1, R67.1, R68.1, R88.2, R89.1, R90.2, R91.1, U16.7 (VCCB), U33.7 (VDD)
+12V: C45.1, J45.2, J46.2, U24.8 (VCC)
GND3: C27.2, C30.2, C31.2, C32.2, C33.2, C45.2, C66.2, C67.2, J47.1, J48.1, Q6.2 (S), R31.2, R81.2, R82.2, R85.2, R86.2, U16.2 (GND), U17.18 (GND), U17.20 (GND), U24.4 (GND), U33.1 (GND), U33.2 (GND), U33.3 (GND), U33.6 (GND), U33.10 (GND), U33.11 (GND)
HTR_1_PWM: Q6.1 (G), R81.1
HTR_2_PWM: Q6.1 (G), R82.1
IMU_INT: U17.12 (INT1)
unnamed: C33.1, U17.10 (REGOUT)
unnamed: J45.1, Q6.3 (D)
unnamed: J46.1, Q6.3 (D)
unnamed: R31.1, U17.11 (FSYNC)
unnamed: R85.1, U33.9 (ADDR)
unnamed: R86.1, U33.9 (ADDR)
unnamed: U33.12 (NC), U33.13 (NC), U33.14 (NC), U33.15 (NC), U33.16 (NC)
SCL_1V8: U16.5 (A1), U17.23 (SCL/SCLK)
SCL_12V_IN: U24.5 (TXD-SCL), U24.6 (RXD-SCL)
SCL_FLOW_3V3: R88.1, R89.2, U16.8 (B1), U33.5 (SCL)
SCL_MAIN_3V3: R68.2, U24.7 (SCL)
SDA_1V8: U16.4 (A2), U17.24 (SDA/SDI)
SDA_12V_IN: U24.2 (RXD-SDA), U24.3 (TXD-SDA)
SDA_FLOW_3V3: R90.1, R91.2, U16.1 (B2), U33.8 (SDA)
SDA_MAIN_3V3: R67.2, U24.1 (SDA)
SDP_IRQn_1: U33.4 (IRQn)
SDP_IRQn_2: U33.4 (IRQn)
TEMP_1: C66.1, J47.2, R25.2
TEMP_2: C67.1, J48.2, R25.2

Notes on the sheet:
Long Range I2C
9 DoF IMU (Compass)
