QuantumMatter/Rumission/Hardware/Daughter Boards/dboards-02/34_flow_rfid.kicad_sch

## KiCad design Hardware/Daughter Boards/dboards-02/34_flow_rfid.kicad_sch (2023-12-21)

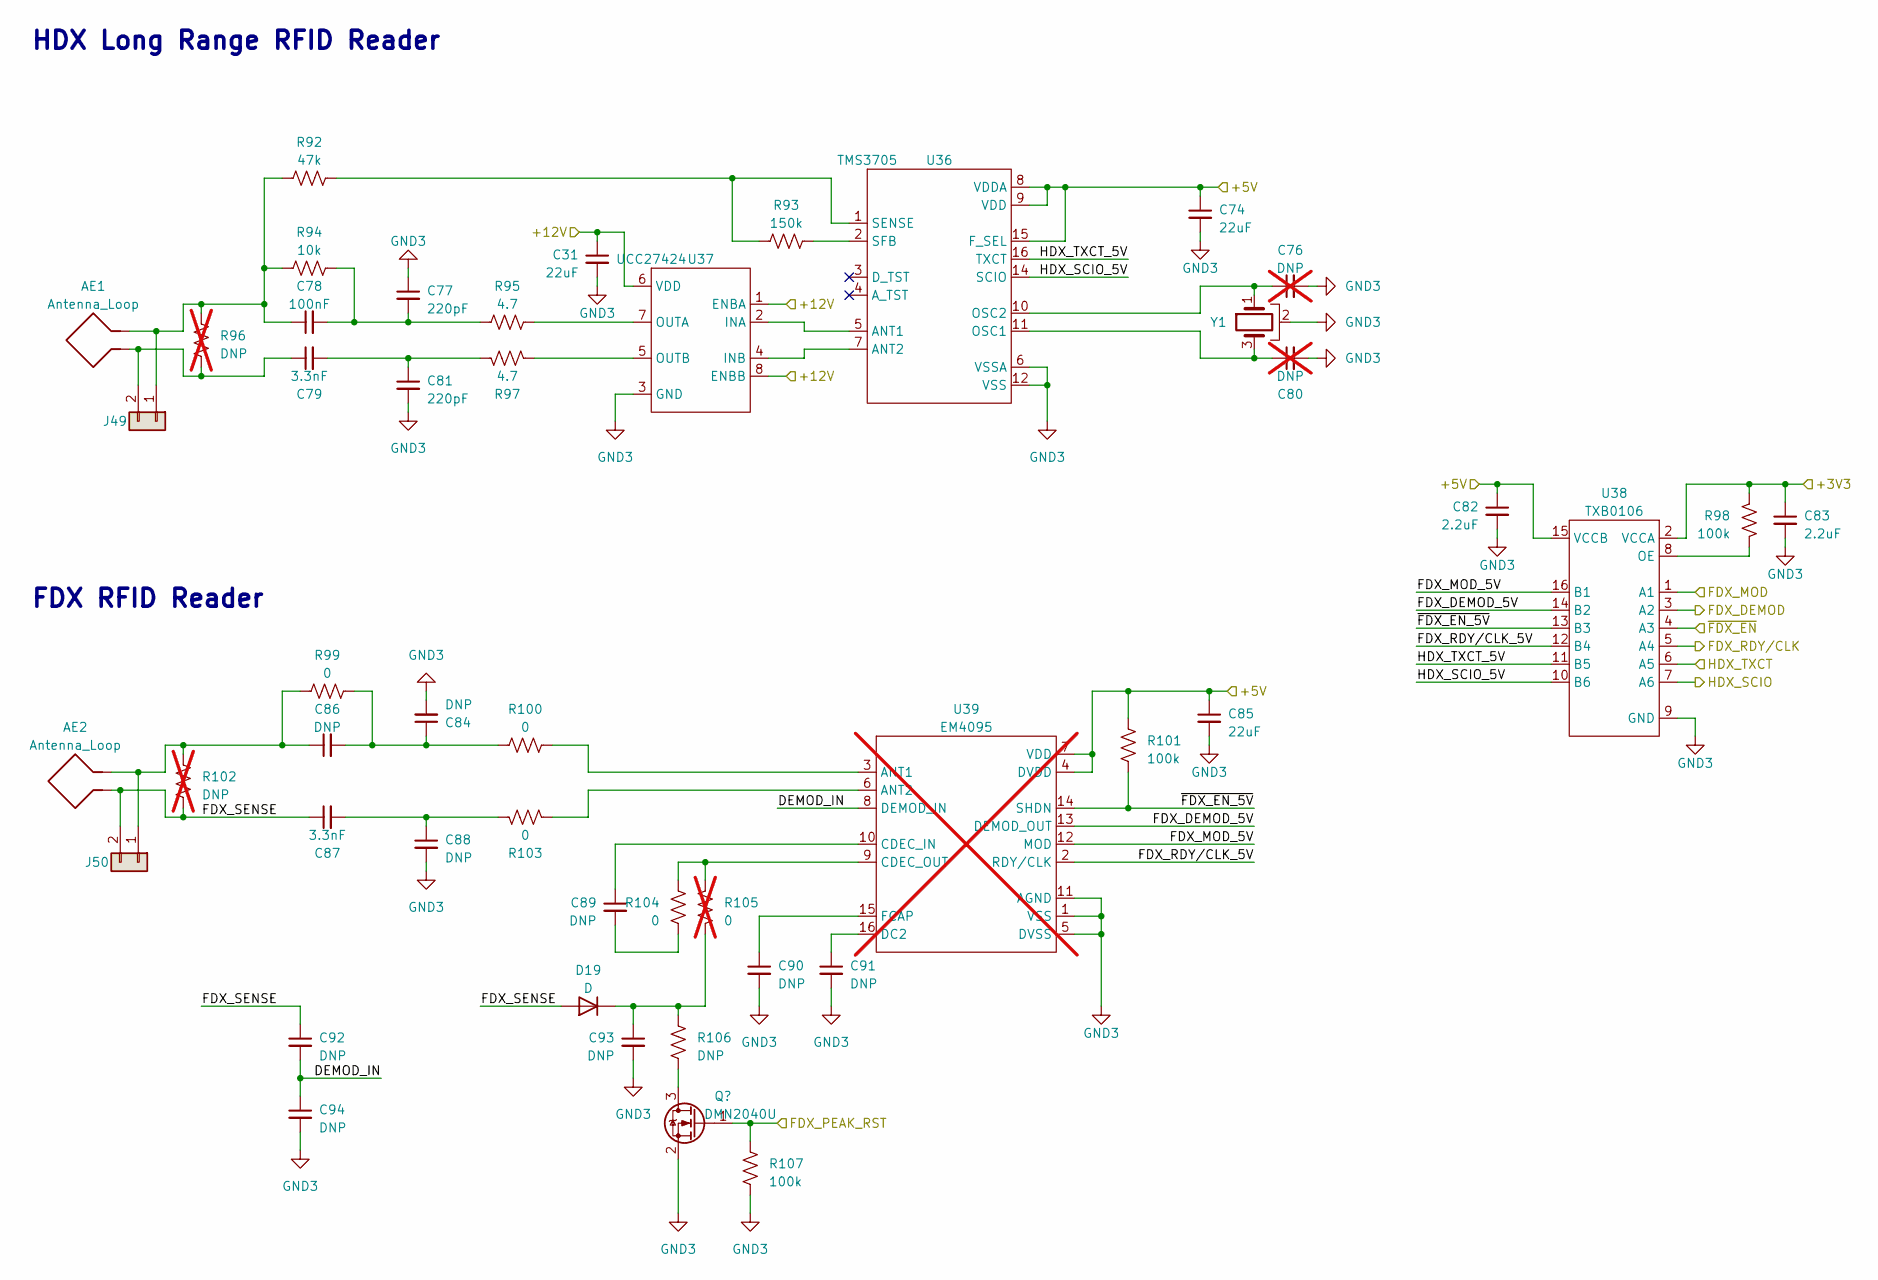
[picture p18: schematic 34_flow_rfid.kicad_sch]

Parts:
AE1, AE2: Antenna_Loop; U.FL_Hirose_U.FL-R-SMT-1_Vertical; MPN U.FL-R-SMT-1(80); DigiKey PN 26-U.FL-R-SMT-1(80)CT-ND
C31, C74, C85: 22uF; CP_Radial_D6.3mm_P2.50mm; MPN EEA-GA1H2R2H; DigiKey PN P15835CT-ND
C76, C80: DNP; C_0805_2012Metric_Pad1.18x1.45mm_HandSolder; not fitted
C77, C81: 220pF; C_1206_3216Metric_Pad1.33x1.80mm_HandSolder; MPN CL31C221JIHNFNE; DigiKey PN 1276-3234-1-ND
C78: 100nF; C_1206_3216Metric_Pad1.33x1.80mm_HandSolder; MPN CC1206JRX7R9BB104; DigiKey PN 311-1435-1-ND
C79, C87: 3.3nF; C_1206_3216Metric_Pad1.33x1.80mm_HandSolder; MPN CL31C332JHHNFNE; DigiKey PN 1276-3259-1-ND
C82, C83: 2.2uF; C_0805_2012Metric_Pad1.18x1.45mm_HandSolder; MPN CL21B225KPFNNNE; DigiKey PN 1276-1188-1-ND
C84, C86, C88, C89, C90, C91, C92, C93, C94: DNP; C_1206_3216Metric_Pad1.33x1.80mm_HandSolder
D19: D; D_SOD-123; MPN 1N4148W-TP; DigiKey PN 1N4148WTPMSCT-ND
J49, J50: Conn_01x02; PinHeader_1x02_P2.54mm_Vertical; MPN 0022284025; DigiKey PN 23-0022284025-ND
Q11: DMN2040U; SOT-523; MPN DMN2040U-13; DigiKey PN 31-DMN2040U-13CT-ND
R92: 47k; R_1206_3216Metric_Pad1.30x1.75mm_HandSolder; MPN RC1206FR-0747KL; DigiKey PN 311-47.0KFRCT-ND
R93: 150k; R_1206_3216Metric_Pad1.30x1.75mm_HandSolder; MPN RC1206FR-07150KL; DigiKey PN 311-150KFRCT-ND
R94: 10k; R_1206_3216Metric_Pad1.30x1.75mm_HandSolder; MPN RC1206FR-0710KL; DigiKey PN 311-10.0KFRCT-ND
R95, R97: 4.7; R_1206_3216Metric_Pad1.30x1.75mm_HandSolder; MPN RC1206FR-074R7L; DigiKey PN 311-4.70FRCT-ND
R96, R102: DNP; R_1206_3216Metric_Pad1.30x1.75mm_HandSolder; not fitted
R98, R101: 100k; R_0805_2012Metric_Pad1.20x1.40mm_HandSolder; MPN RC0805FR-07100KL; DigiKey PN 311-100KCRCT-ND
R99, R100, R103, R104: 0; R_1206_3216Metric_Pad1.30x1.75mm_HandSolder; MPN RC1206JR-070RL; DigiKey PN 311-0.0ERCT-ND
R105: 0; R_1206_3216Metric_Pad1.30x1.75mm_HandSolder; MPN RC1206JR-070RL; DigiKey PN 311-0.0ERCT-ND; not fitted
R106: DNP; R_1206_3216Metric_Pad1.30x1.75mm_HandSolder
R107: 100k; R_1206_3216Metric_Pad1.30x1.75mm_HandSolder; MPN RC1206FR-07100KL; DigiKey PN 311-100KFRCT-ND
U36: TMS3705; SOIC-16_3.9x9.9mm_P1.27mm; MPN TMS3705EDRQ1; DigiKey PN 296-53255-1-ND
U37: UCC27424; PowerPad_VSSOP-8; MPN UCC27424DGN; DigiKey PN 296-15868-5-ND
U38: TXB0106; Texas_RGY_R-PVQFN-N16_EP2.05x2.55mm; MPN TXB0106IPWRQ1; DigiKey PN 296-24960-1-ND
U39: EM4095; SOIC-16_3.9x9.9mm_P1.27mm; not fitted
Y1: CSTNR4M00GH5L000R0; Resonator_SMD_Murata_CDSCB-2Pin_4.5x2.0mm_HandSoldering; MPN CSTNR4M00GH5L000R0; DigiKey PN 490-17964-1-ND

Connections:
+3V3: C83.1, R98.1, U38.2 (VCCA)
+5V: C74.1, C82.1, C85.1, R101.1, U36.8 (VDDA), U36.9 (VDD), U36.15 (F_SEL), U38.15 (VCCB), U39.4 (DVDD), U39.7 (VDD)
+12V: C31.1, U37.1 (ENBA), U37.6 (VDD), U37.8 (ENBB)
DEMOD_IN: C92.2, C94.1, U39.8 (DEMOD_IN)
FDX_DEMOD: U38.3 (A2)
FDX_DEMOD_5V: U38.14 (B2), U39.13 (DEMOD_OUT)
FDX_MOD: U38.1 (A1)
FDX_MOD_5V: U38.16 (B1), U39.12 (MOD)
FDX_PEAK_RST: Q11.1 (G), R107.1
FDX_RDY/CLK: U38.5 (A4)
FDX_RDY/CLK_5V: U38.12 (B4), U39.2 (RDY/CLK)
FDX_SENSE: AE2.1, C87.1, C92.1, D19.2 (A), J50.2, R102.1
GND3: C31.2, C74.2, C76.2, C77.1, C80.2, C81.2, C82.2, C83.2, C84.2, C85.2, C88.2, C90.2, C91.2, C93.2, C94.2, Q11.2 (S), R107.2, U36.6 (VSSA), U36.12 (VSS), U37.3 (GND), U38.9 (GND), U39.1 (VSS), U39.5 (DVSS), U39.11 (AGND), Y1.2
HDX_SCIO: U38.7 (A6)
HDX_SCIO_5V: U36.14 (SCIO), U38.10 (B6)
HDX_TXCT: U38.6 (A5)
HDX_TXCT_5V: U36.16 (TXCT), U38.11 (B5)
unnamed: AE1.1, C79.1, J49.2, R96.1
unnamed: AE1.2, C78.1, J49.1, R92.1, R94.1, R96.2
unnamed: AE2.2, C86.1, J50.1, R99.1, R102.2
unnamed: C76.1, U36.10 (OSC2), Y1.1
unnamed: C77.2, C78.2, R94.2, R95.1
unnamed: C79.2, C81.1, R97.1
unnamed: C80.1, U36.11 (OSC1), Y1.3
unnamed: C84.1, C86.2, R99.2, R100.1
unnamed: C87.2, C88.1, R103.1
unnamed: C89.1, U39.10 (CDEC_IN)
unnamed: C89.2, R104.2
unnamed: C90.1, U39.15 (FCAP)
unnamed: C91.1, U39.16 (DC2)
unnamed: C93.1, D19.1 (K), R105.2, R106.1
unnamed: Q11.3 (D), R106.2
unnamed: R92.2, R93.1, U36.1 (SENSE)
unnamed: R93.2, U36.2 (SFB)
unnamed: R95.2, U37.7 (OUTA)
unnamed: R97.2, U37.5 (OUTB)
unnamed: R98.2, U38.8 (OE)
unnamed: R100.2, U39.3 (ANT1)
unnamed: R103.2, U39.6 (ANT2)
unnamed: R104.1, R105.1, U39.9 (CDEC_OUT)
unnamed: U36.5 (ANT1), U37.2 (INA)
unnamed: U36.7 (ANT2), U37.4 (INB)
~FDX_EN_5V: R101.2, U38.13 (B3), U39.14 (SHDN)
~FDX_EN: U38.4 (A3)

Notes on the sheet:
FDX RFID Reader
HDX Long Range RFID Reader
