QuantumMatter/Rumission/Hardware/Daughter Boards/dboards-02/dboards-02.kicad_sch

## KiCad design Hardware/Daughter Boards/dboards-02/dboards-02.kicad_sch (2023-12-21)

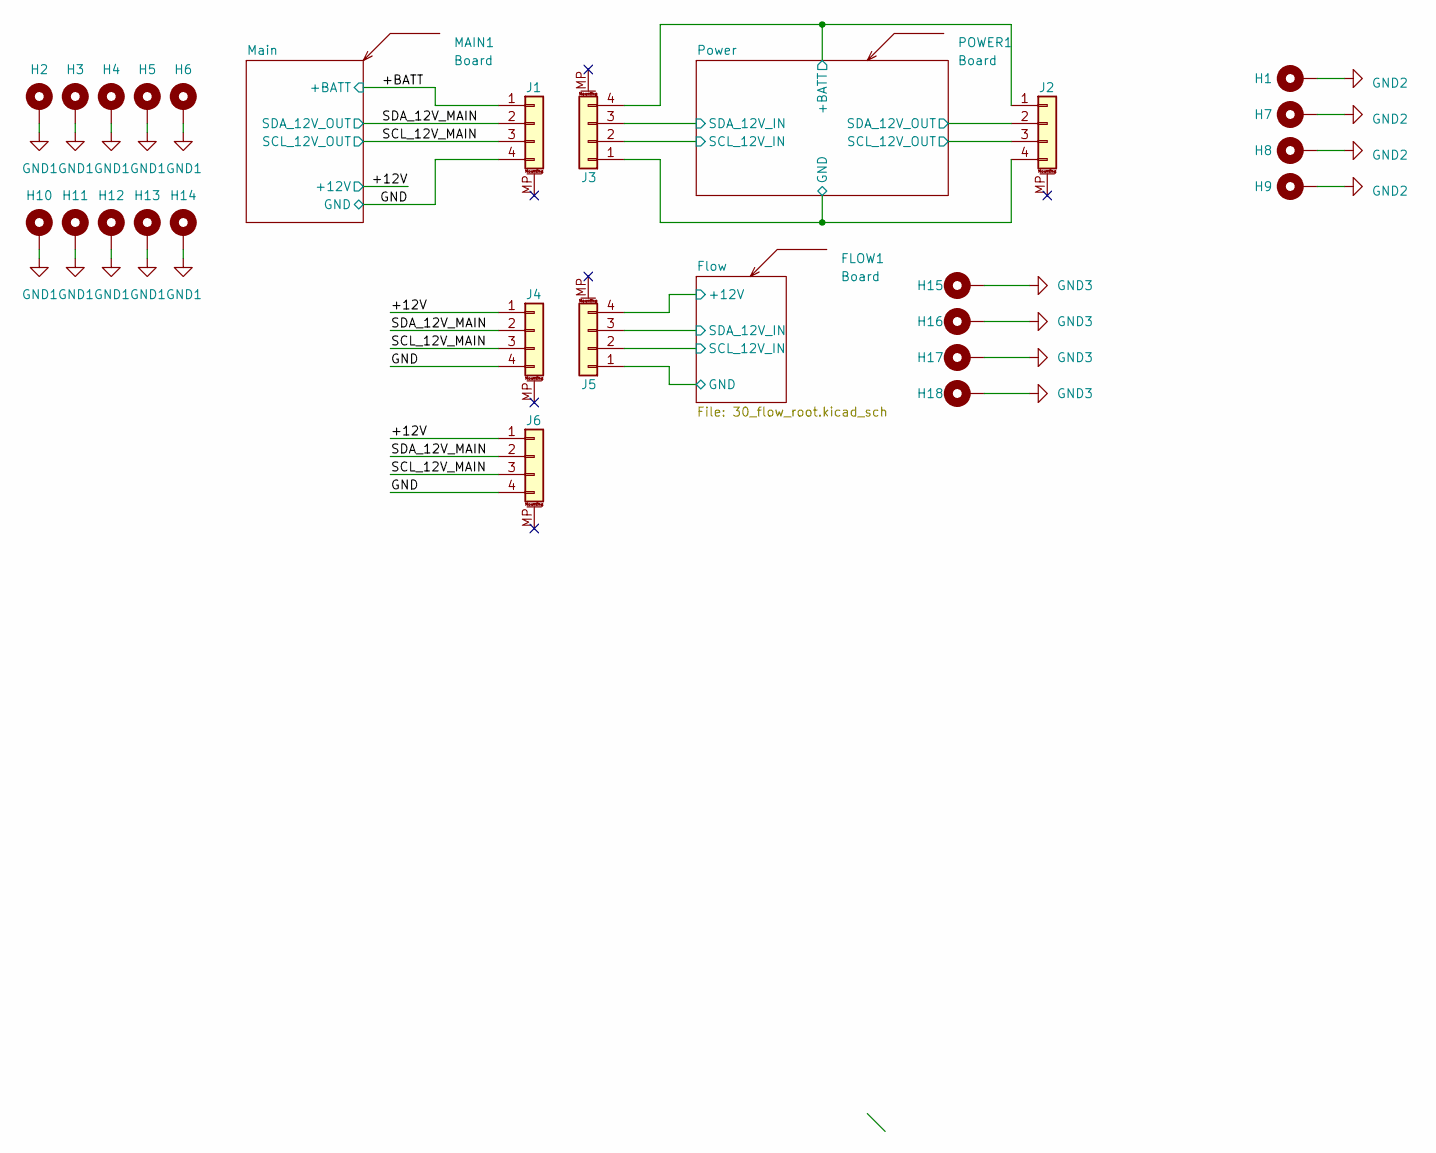
[picture p19: schematic dboards-02.kicad_sch]

Parts:
FLOW1: Board
H1, H7, H8, H9, H10, H11, H12, H13, H14, H15, H16, H17, H18: MountingHole_Pad; MountingHole_3.2mm_M3_DIN965_Pad
H2, H3, H4, H5, H6: MountingHole_Pad; MountingHole_6.4mm_M6_DIN965_Pad
J1, J2, J3, J4, J5, J6: Conn_01x04_MountingPin; JST_XH_B4B-XH-AM_1x04_P2.50mm_Vertical; MPN B4B-XH-AM(LF)(SN); DigiKey PN 455-2237-ND
MAIN1: Board
POWER1: Board

Connections:
+12V: J4.1, J5.4, J6.1
+BATT: J1.1, J2.1, J3.4
GND: J1.4, J2.4, J3.1, J4.4, J5.1, J6.4
GND1: H2.1, H3.1, H4.1, H5.1, H6.1, H10.1, H11.1, H12.1, H13.1, H14.1
GND2: H1.1, H7.1, H8.1, H9.1
GND3: H15.1, H16.1, H17.1, H18.1
SCL_12V_IN: J3.2, J5.2
SCL_12V_MAIN: J1.3, J4.3, J6.3
SCL_12V_OUT: J2.3
SDA_12V_IN: J3.3, J5.3
SDA_12V_MAIN: J1.2, J4.2, J6.2
SDA_12V_OUT: J2.2
